UrryUrr/ushayka-sklon-3d/img/fig/r5_design_river.jpg

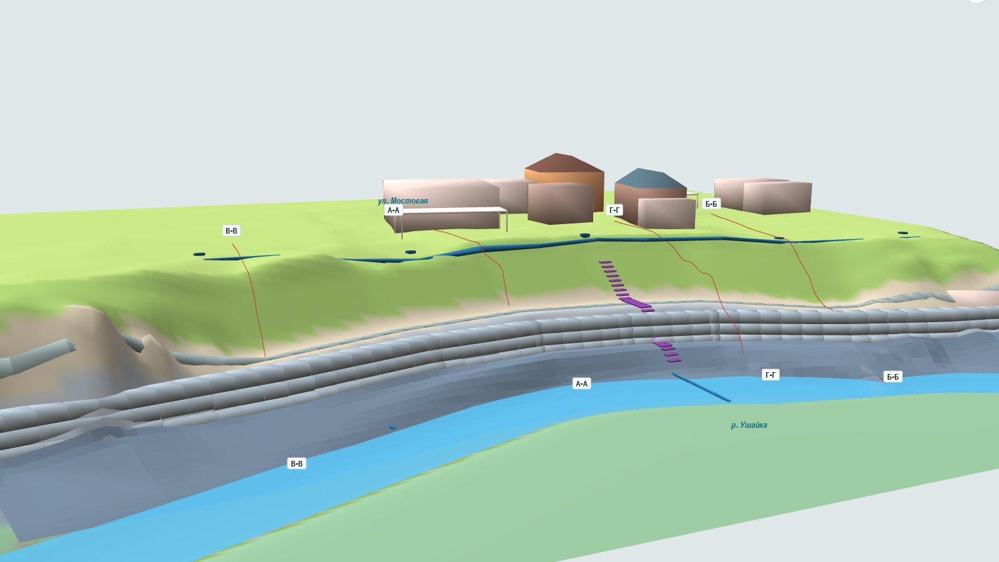
img/fig/r5_design_river.jpg
