UrryUrr/ushayka-sklon-3d/img/fig/r2_design.jpg

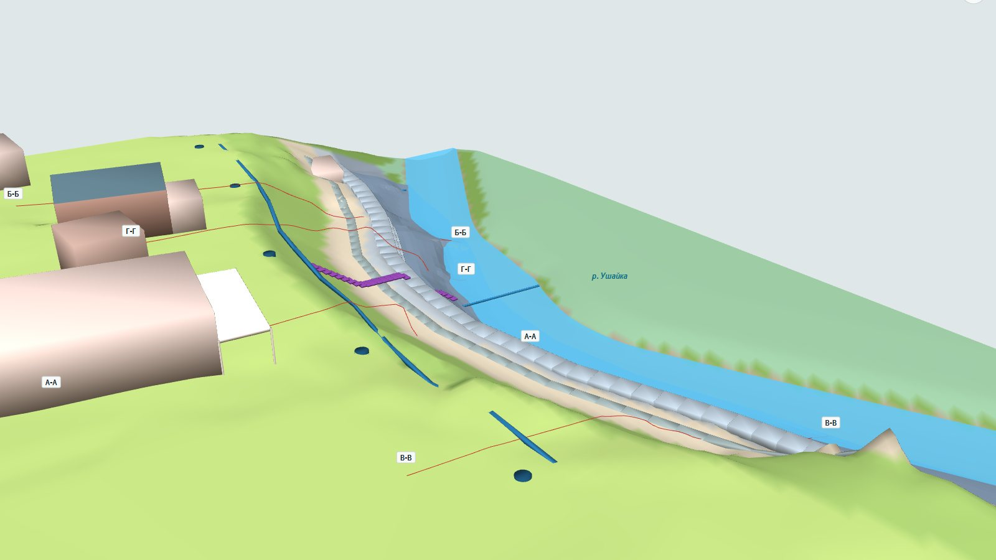
img/fig/r2_design.jpg
