UrryUrr/ushayka-sklon-3d/docs/README.txt

ПРОЕКТ БЕРЕГОУКРЕПЛЕНИЯ — п. Заварзино, ул. Мостовая, 40 (левый берег р. Ушайки)
Шифр 2026-МОС40-ИЗ. Предпроектные решения (концепция) с расчётным обоснованием. ЧЕРНОВИК. Подготовлено 22.10.2026.

СТАТУС
Документы подготовлены по материалам заказчика: отчёту ИГИ 188-07/2024 (ООО «Сибирская Буровая Компания»,
доп. от 02.07.2025) и заключению ООО «НПФ «Инженерные изыскания» (2025). Это не проектная документация организации —
члена СРО. Перед строительством её должен проверить и подписать ГИП такой организации; до рабочей документации
обязательны доизыскания (ПЗ, раздел 15).

СОСТАВ ПАПКИ
01_Пояснительная записка  — ПЗ, 32 стр.: условия, причины деформаций, расчёты, варианты, решения, ПОС, мониторинг,
                            разрешения, стоимость, задание на доизыскания.
02_Чертежи                — 13 листов А2 (PDF): общие данные, планы М 1:400 (существующее, проект), разрезы А-А, Б-Б, В-В,
                            Г-Г М 1:200, контрфорсы ГЦК, габионы и крепление подошвы, дренаж, стройгенплан, мониторинг, 3D.
                            DXF — план проектных решений в МСК-70 (X/Y как в топоплане) и разрезы.
03_Расчёты                — results.json (все коэффициенты устойчивости, оползневое давление, объёмы), графики сечений,
                            исходный код расчётной модели (Python: Бишоп, Спенсер, метод передачи сил, сваи, ЦМР, 3D).
04_3D-модель              — 3D-модель_Заварзино.html (открыть в браузере, нужен интернет для библиотеки three.js),
                            model.obj/.mtl (Civil 3D, Revit, Blender), ЦМР «сущ./проект» (npz), виды PNG.
                            Онлайн-версия: https://urryurr.github.io/ushayka-sklon-3d/ (3D-модель и вся документация).
05_Смета                  — ведомость объёмов по зонам I–III, укрупнённая стоимость (мин/макс, без НДС), варианты по бюджету;
                            «Обоснование стоимости» (PDF): расценки, источники цен, расчёт цены струйной цементации.

ГЛАВНЫЕ ВЫВОДЫ
1. При расчётных характеристиках грунтов (как требует СП 116.13330.2012) устойчивость не обеспечена по всему фронту ≈ 100 м:
   k = 0,93 (А-А), 0,96 (Г-Г), 1,00 (В-В), 1,01 (Б-Б) при норме 1,15; весной (верховодка) 0,87–0,97; при сейсмике 0,84–0,89.
   PLAXIS в заключении дал 1,17 по А-А при нормативных характеристиках; та же модель здесь даёт 1,19–1,21.
   По разрезу Б-Б заключение дало 1,49, наша модель — 1,10: расхождение нужно разобрать с автором заключения.
2. Расчётные поверхности скольжения глубокие (на 13–15 м ниже двора) и выходят в русло; верх — на дворе в 6–8 м от бровки.
3. Рекомендуемое решение: демонтаж аварийных сооружений, перехватывающий дренаж и ГДС, разгрузка откоса 1:1,5, берма +105,
   40 грунтоцементных контрфорсов (струйная цементация, колонны Ø1,0 м, шаг рёбер 2,5 м, низ 90,0), обвязочная балка,
   габионная стена, матрацы Рено с фартуком. Проект: k = 1,25–1,31 (основное), 1,11–1,15 (сейсмика) — норма выполнена.
4. Буронабивные сваи отклонены: в текучих грунтах ниже скольжения велики смещения, не хватает несущей способности
   на выдёргивание, тяжёлая установка на склоне опасна.
5. Стоимость ориентировочная (±30 %, без НДС; обоснование — 05_Смета, «Обоснование стоимости»): всего 88–139 млн руб.;
   этап 0 + 1 (аварийная зона I, ≈ 42 м) — 43–70 млн руб.; неотложный этап (дренаж, доизыскания, датчики) — 7,9–13,6 млн руб.;
   первоочередные меры — 1,6–2,9 млн руб.
   После CD-испытаний грунтов стоимость рёбер в зонах II–III может снизиться на 30–50 % или вырасти, если грунты окажутся хуже.
   С НДС 22 %: ≈ 107–170 млн руб. (весь участок), ≈ 53–85 млн руб. (первая очередь).
6. Сейсмика 7 баллов: по Спенсеру 1,09–1,13 при норме 1,09 — на пределе, без запаса; в РД добавить запас на участках В-В и Г-Г.
7. Во время стройки, пока рёбра не готовы, запас ниже нормы (1,01–1,05 при 1,09) — короткие захватки и ежедневный контроль.

СДЕЛАТЬ СРАЗУ (этап 0)
— закрыть доступ на склон в зоне I (у сечения А-А) и запретить его использование арендаторам;
— убрать нагрузки в полосе 10 м от бровки, отвести воду с кровель и плато от склона;
— просверлить разгрузочные отверстия в стенах W2, W3, W5, W6;
— заказать доизыскания (глубокие скважины 25–30 м, CD/CU-испытания, гидрология, промеры), инклинометры И-1…И-3;
— начать оформление прав на землю под склоном и водопользования (склон — вне участков, в водоохранной зоне).

ЗАМЕЧАНИЯ К ИСХОДНЫМ МАТЕРИАЛАМ
— Координаты скв. С-3 и С-4 в каталоге ИГИ расходятся с картой и разрезами на 5 и 18 м (принято по карте).
— В прил. Ж ИГИ «расчётные» φ и c для ИГЭ-304 (21–24°, 23–34 кПа) и ИГЭ-406 противоречат испытаниям (прил. Е).
— Гидрография в ИГИ описана по р. Малой Ушайке; гидрологических изысканий нет — РУВВ 103,00 принят условно.
— Скважины на склоне пройдены лишь до 3–4 м; ниже отм. 94,5 данных нет.

ПАРАЛЛЕЛЬНЫЙ ПРОЕКТ
Первоочередные меры с минимальным бюджетом и оценка предложения по винтовым сваям (шифр 2026-МОС40-ПМ) —
отдельная папка «Проект первоочередных мер 2026» рядом с этой; страница: https://urryurr.github.io/ushayka-sklon-3d/pm/
