UrryUrr/ushayka-sklon-3d/img/fig/f1_now.jpg

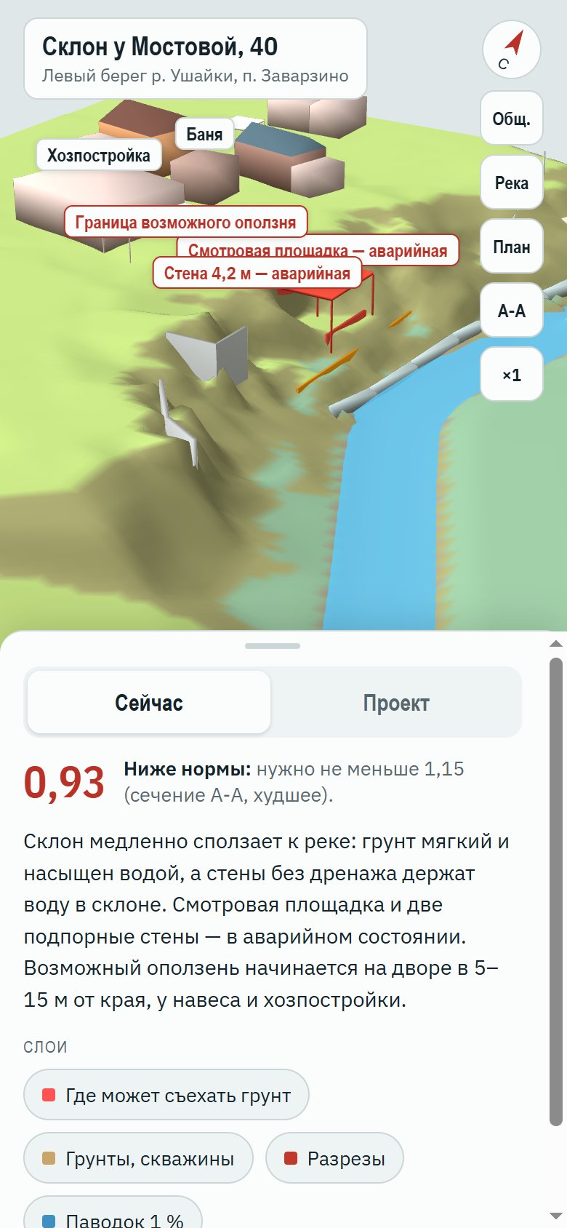
img/fig/f1_now.jpg
