UrryUrr/ushayka-sklon-3d/img/fig/f2_prj.jpg

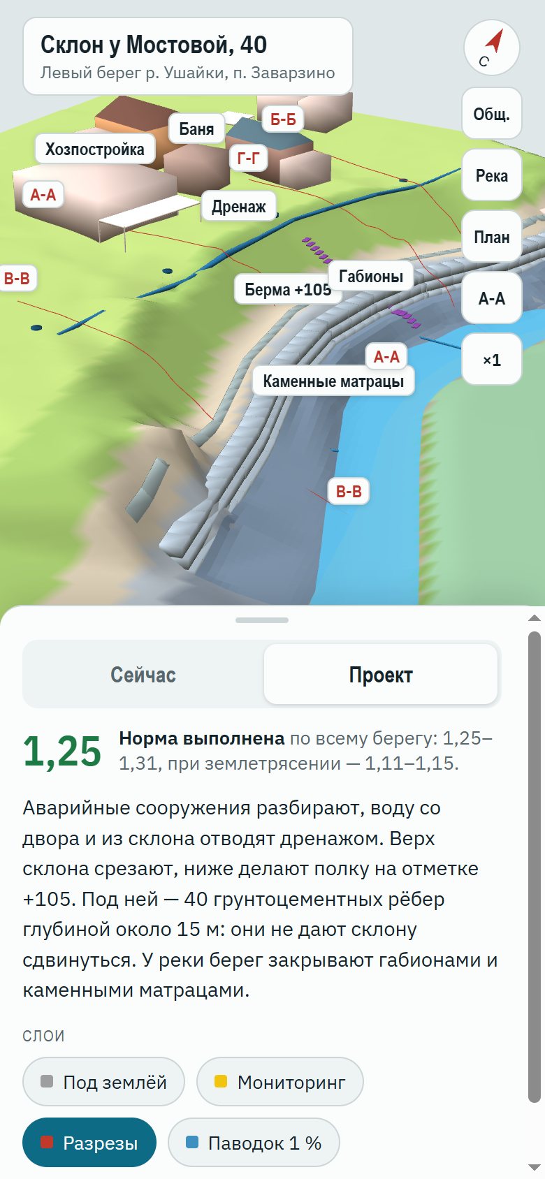
img/fig/f2_prj.jpg
