UrryUrr/ushayka-sklon-3d/img/fig/f3_ug.jpg

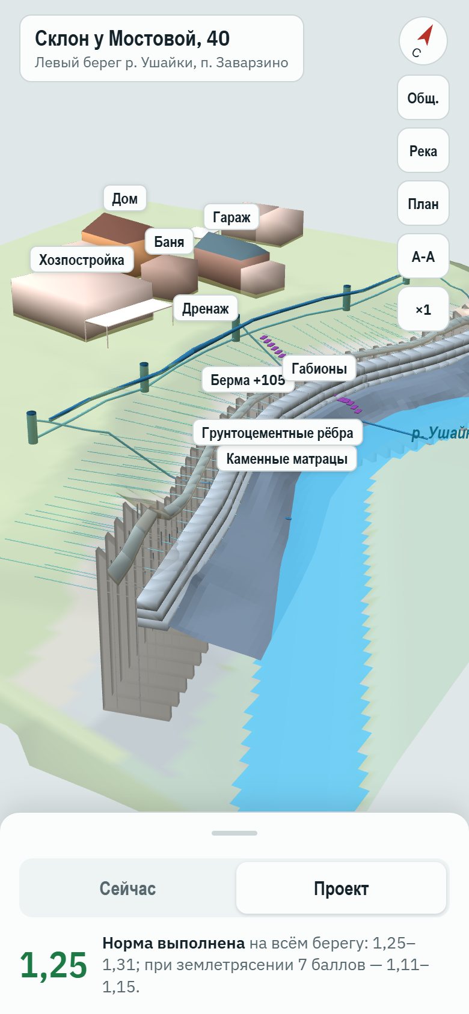
img/fig/f3_ug.jpg
