UrryUrr/ushayka-sklon-3d/img/fig/photo2.jpg

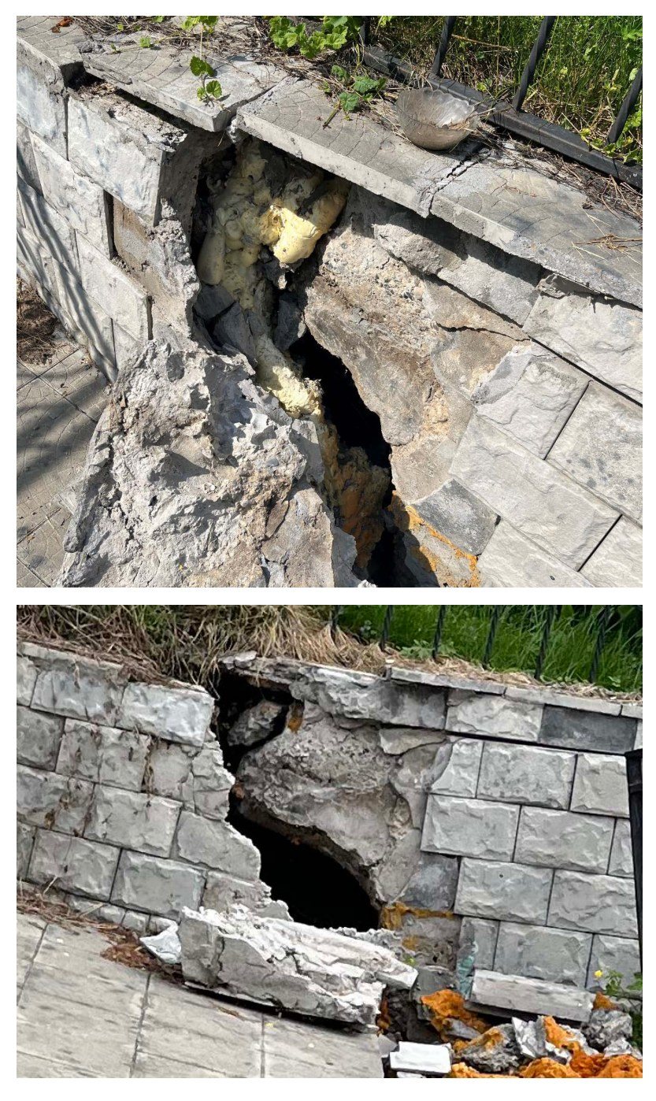
img/fig/photo2.jpg
