UrryUrr/ushayka-sklon-3d/img/fig/photo.jpg

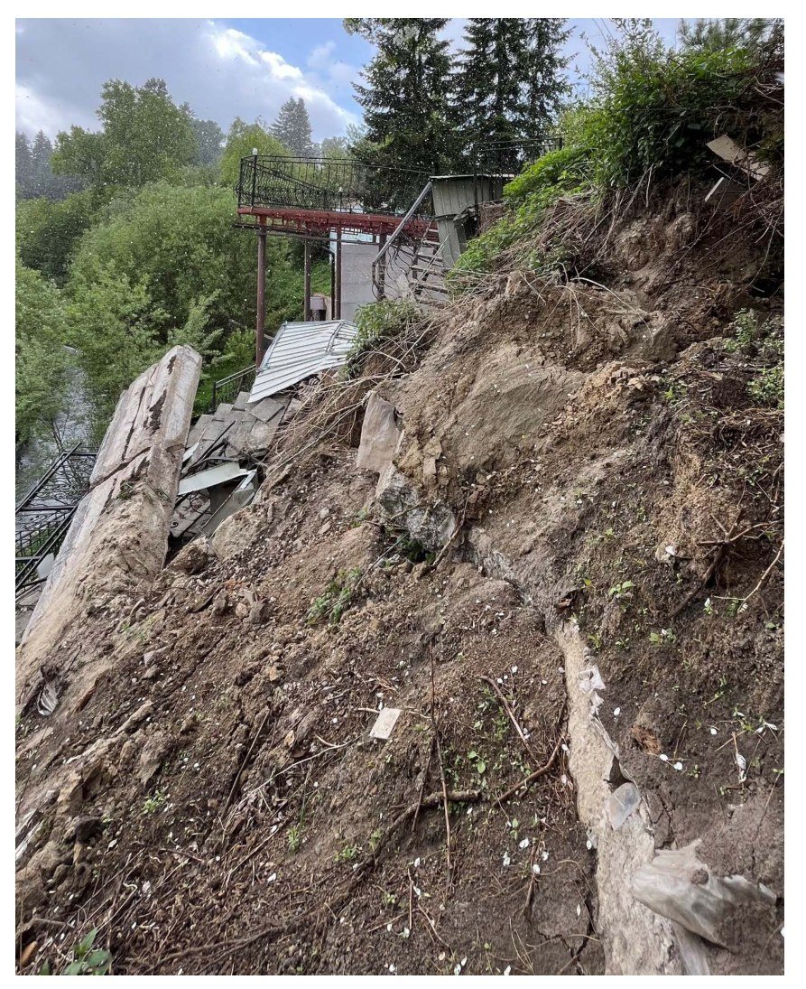
img/fig/photo.jpg
