UrryUrr/ushayka-sklon-3d/img/fig/r1_exist.jpg

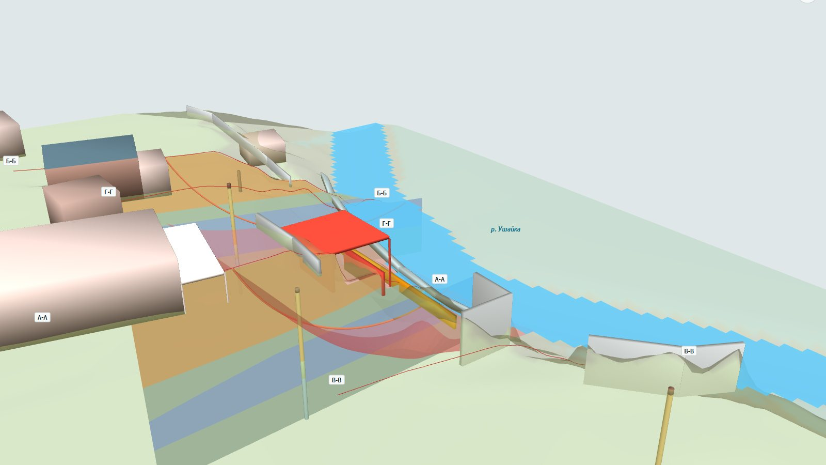
img/fig/r1_exist.jpg
