UrryUrr/ushayka-sklon-3d/img/fig/r4_exist_river.jpg

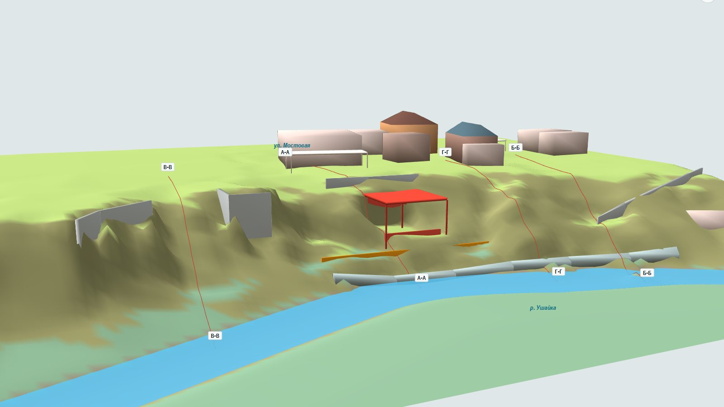
img/fig/r4_exist_river.jpg
