UrryUrr/ushayka-sklon-3d/img/fig/r7_plan.jpg

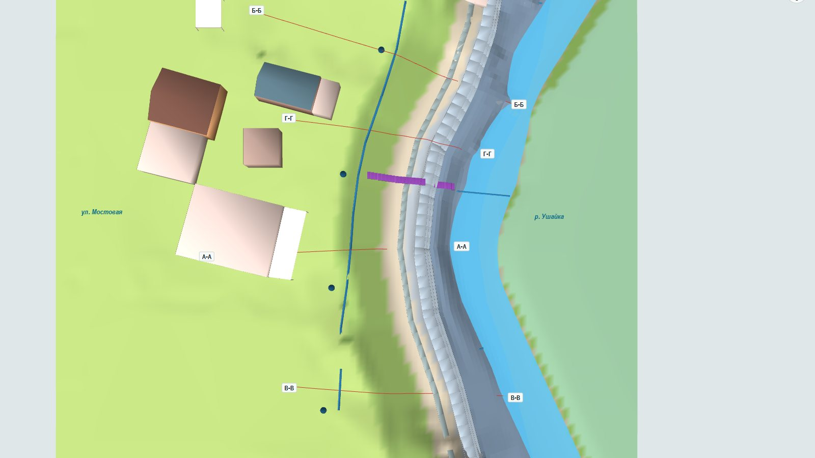
img/fig/r7_plan.jpg
