UrryUrr/ushayka-sklon-3d/img/fig/r8_aa.jpg

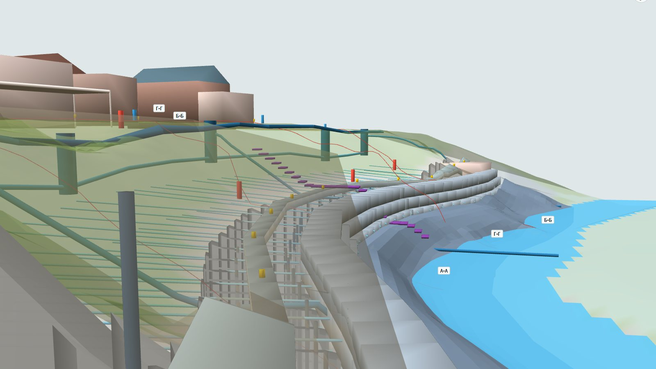
img/fig/r8_aa.jpg
