UrryUrr/ushayka-sklon-3d/img/fig/sec_GG.jpg

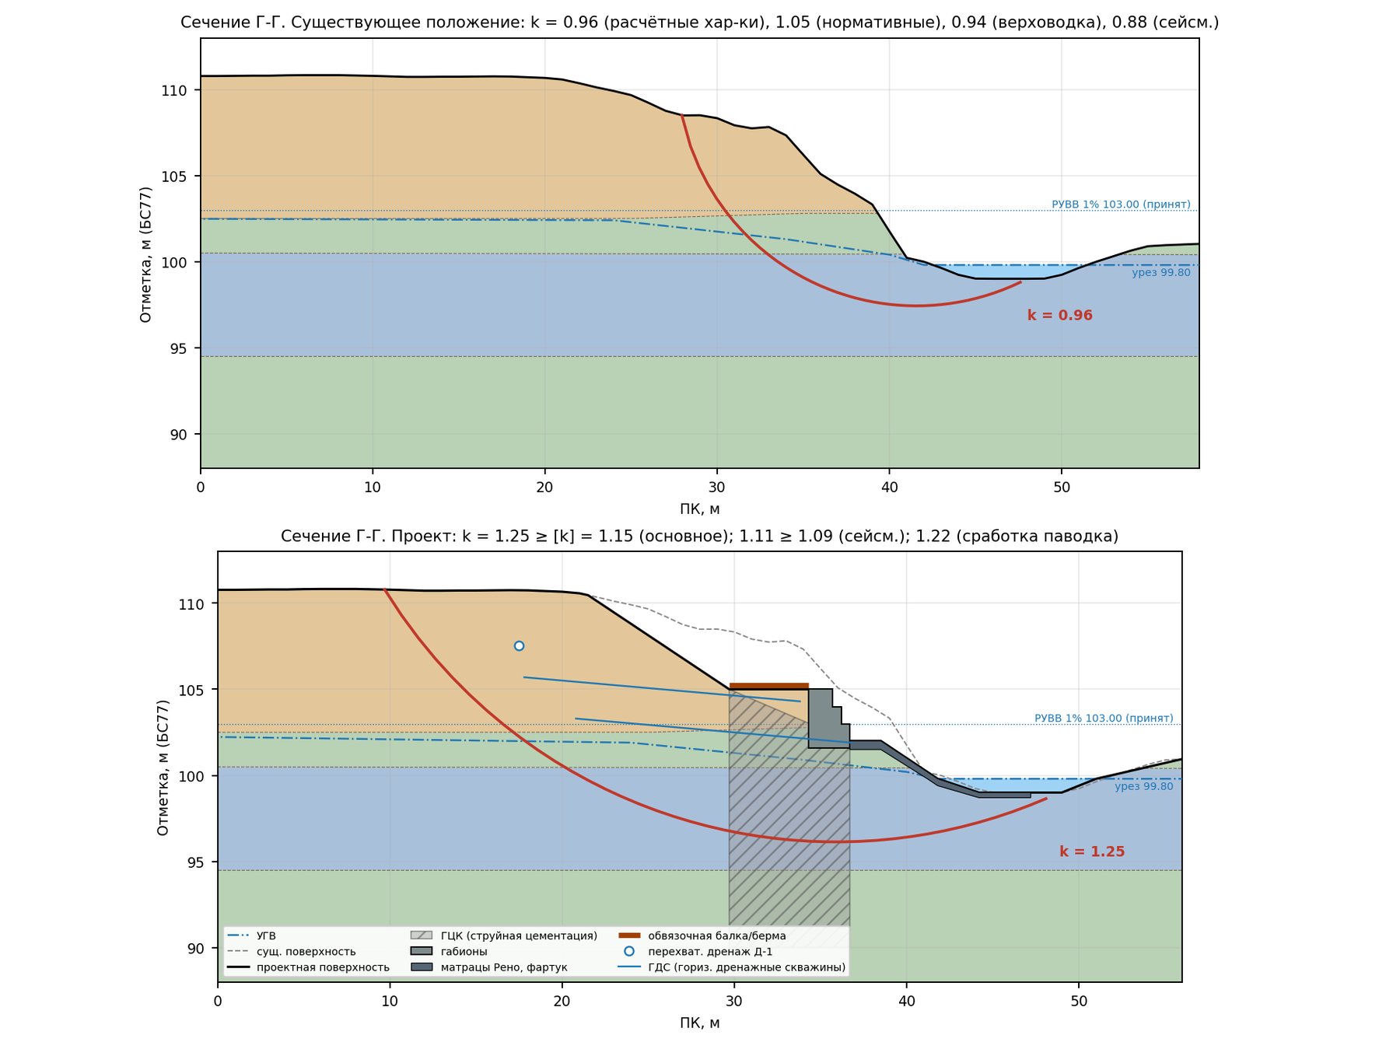
img/fig/sec_GG.jpg
