UrryUrr/ushayka-sklon-3d/img/fig/sec_VV.jpg

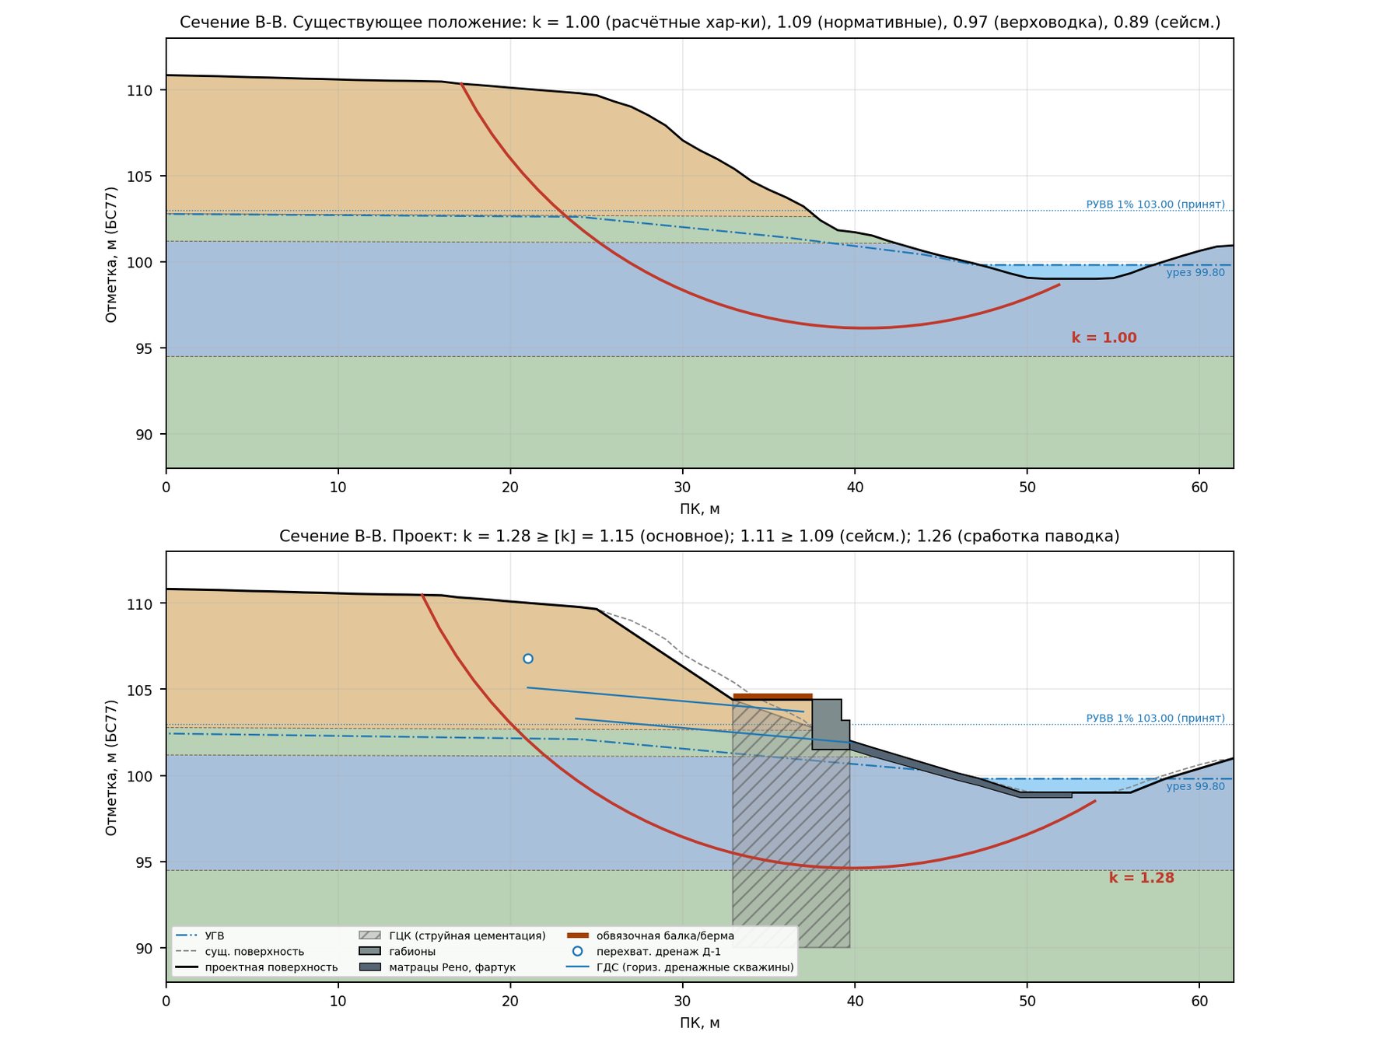
img/fig/sec_VV.jpg
