UrryUrr/ushayka-sklon-3d/img/fig/thrust.jpg

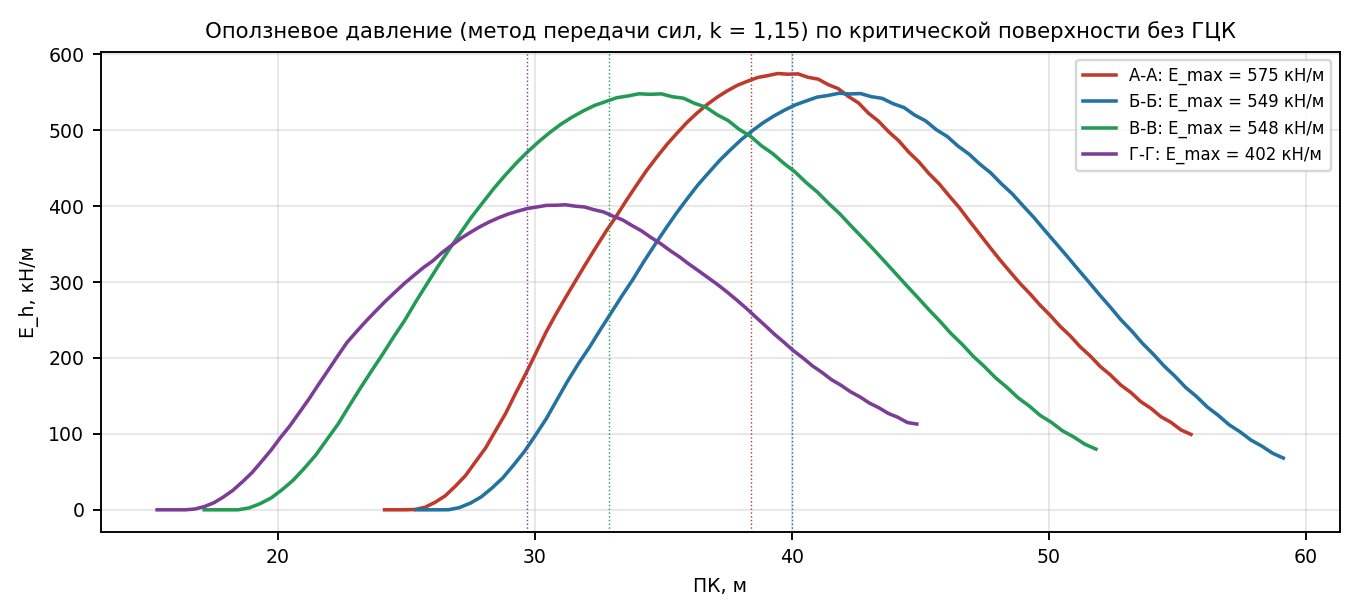
img/fig/thrust.jpg
