UrryUrr/ushayka-sklon-3d/img/sheets/list_01.jpg

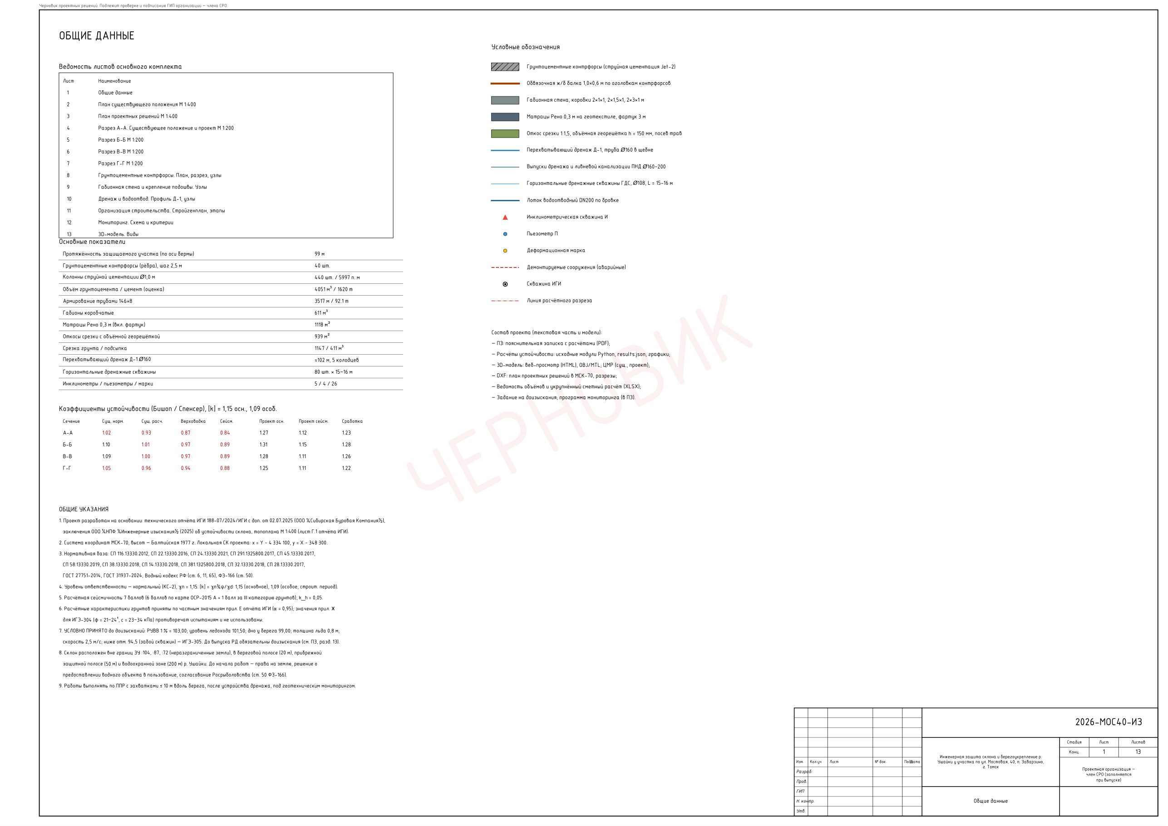
img/sheets/list_01.jpg
