UrryUrr/ushayka-sklon-3d/img/sheets/list_02.jpg

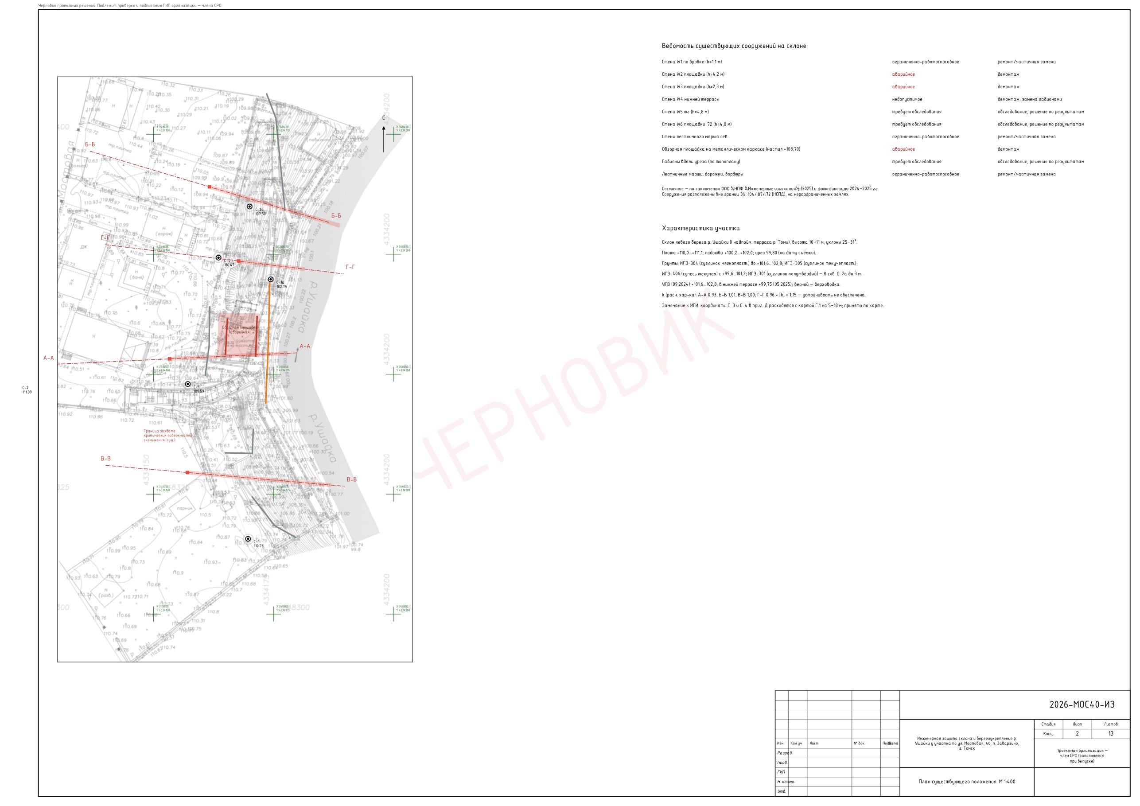
img/sheets/list_02.jpg
