UrryUrr/ushayka-sklon-3d/img/sheets/list_03.jpg

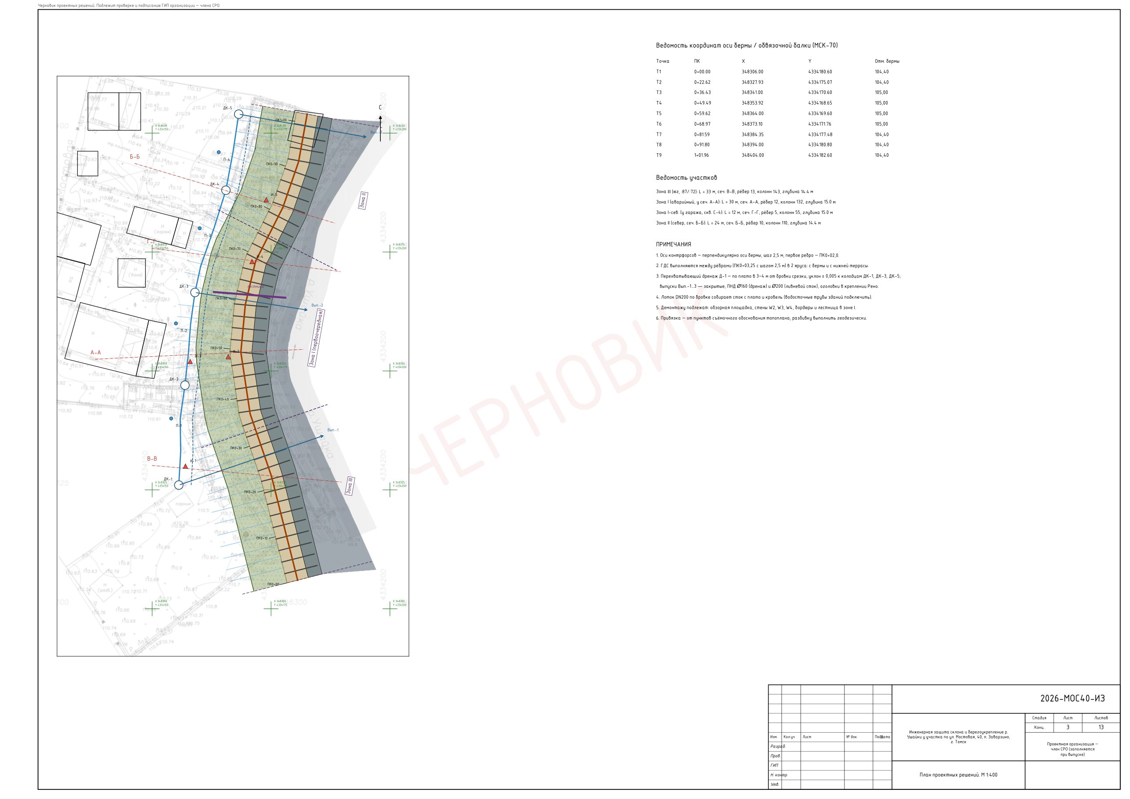
img/sheets/list_03.jpg
