UrryUrr/ushayka-sklon-3d/img/sheets/list_04.jpg

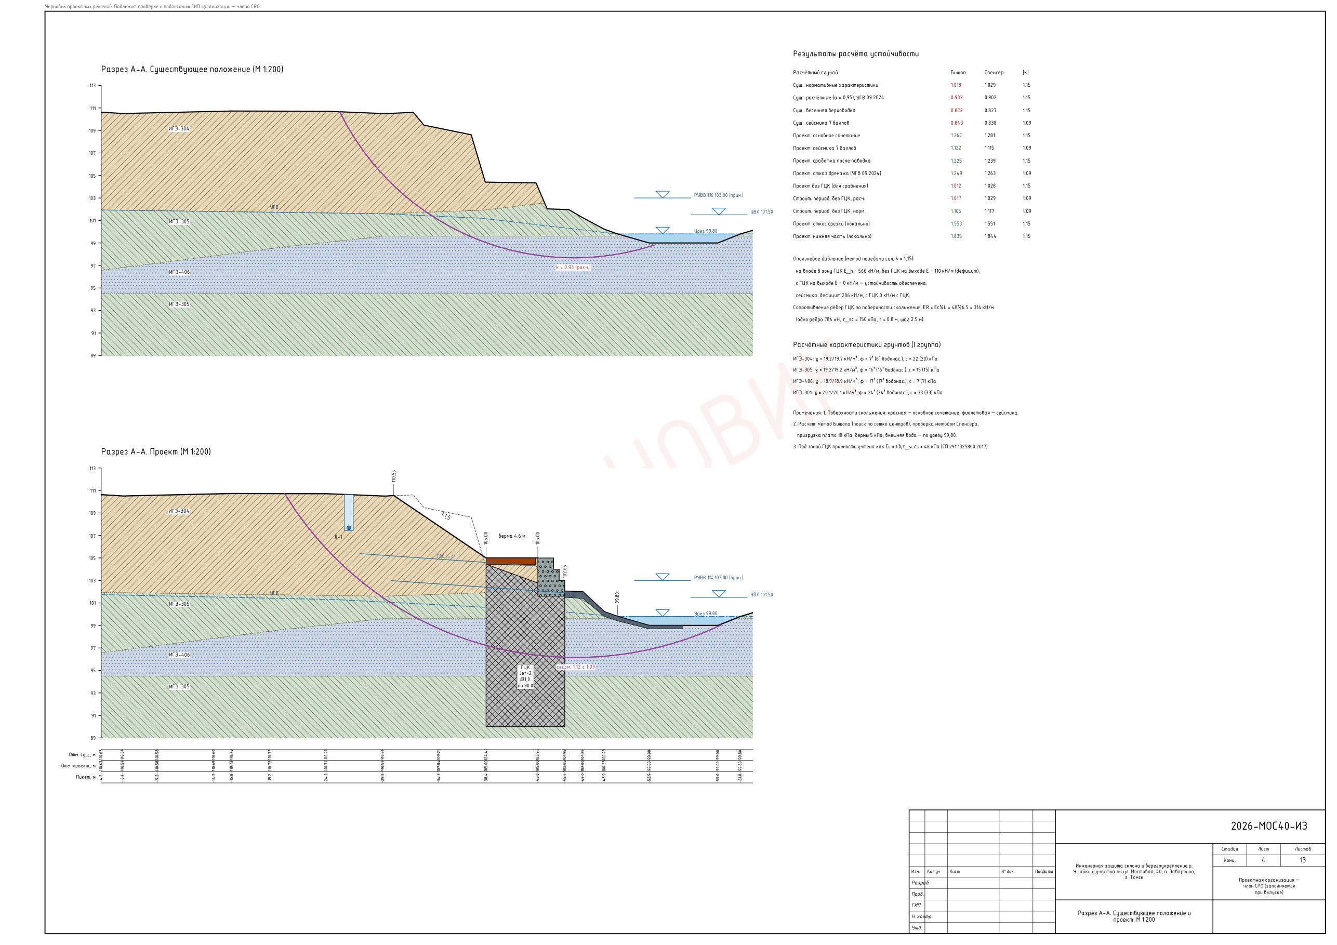
img/sheets/list_04.jpg
