UrryUrr/ushayka-sklon-3d/img/sheets/list_08.jpg

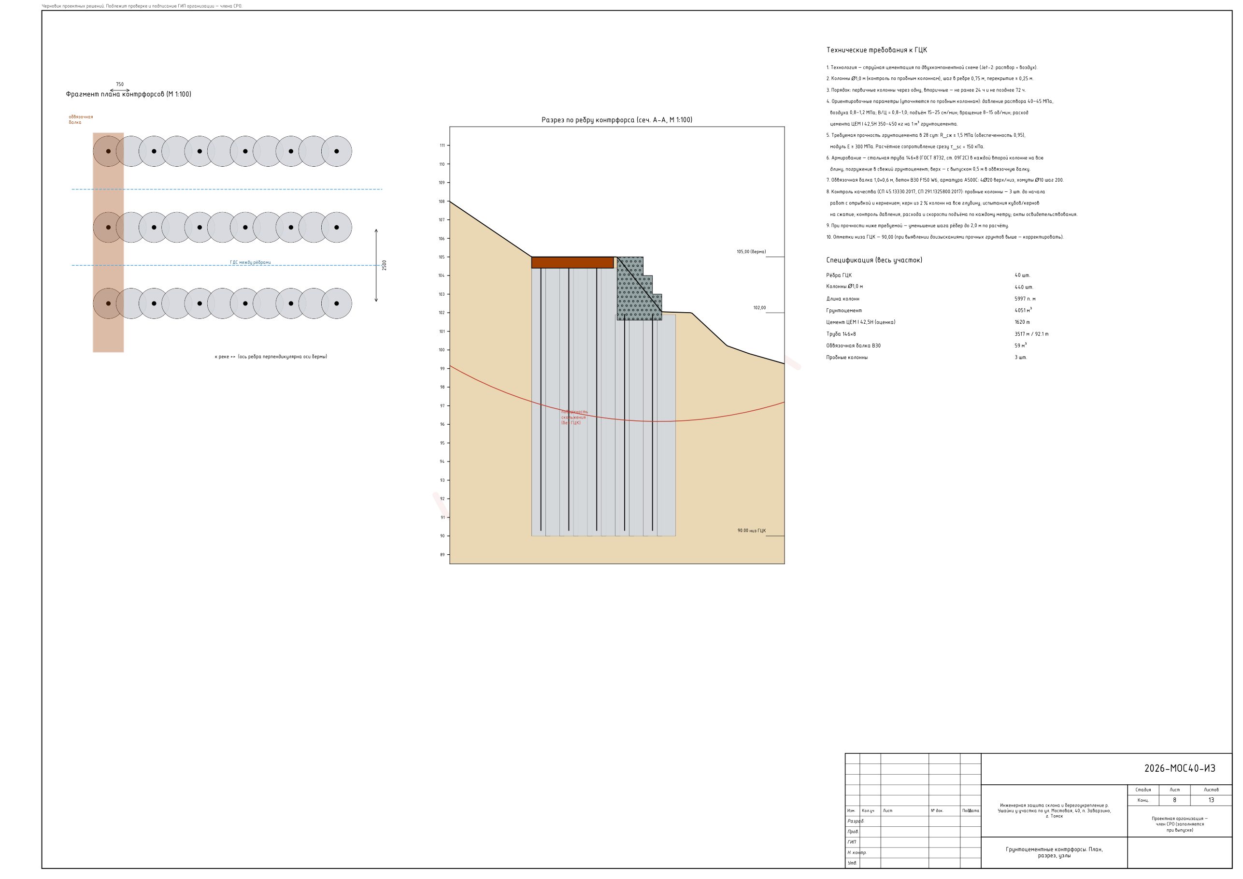
img/sheets/list_08.jpg
