UrryUrr/ushayka-sklon-3d/img/sheets/list_09.jpg

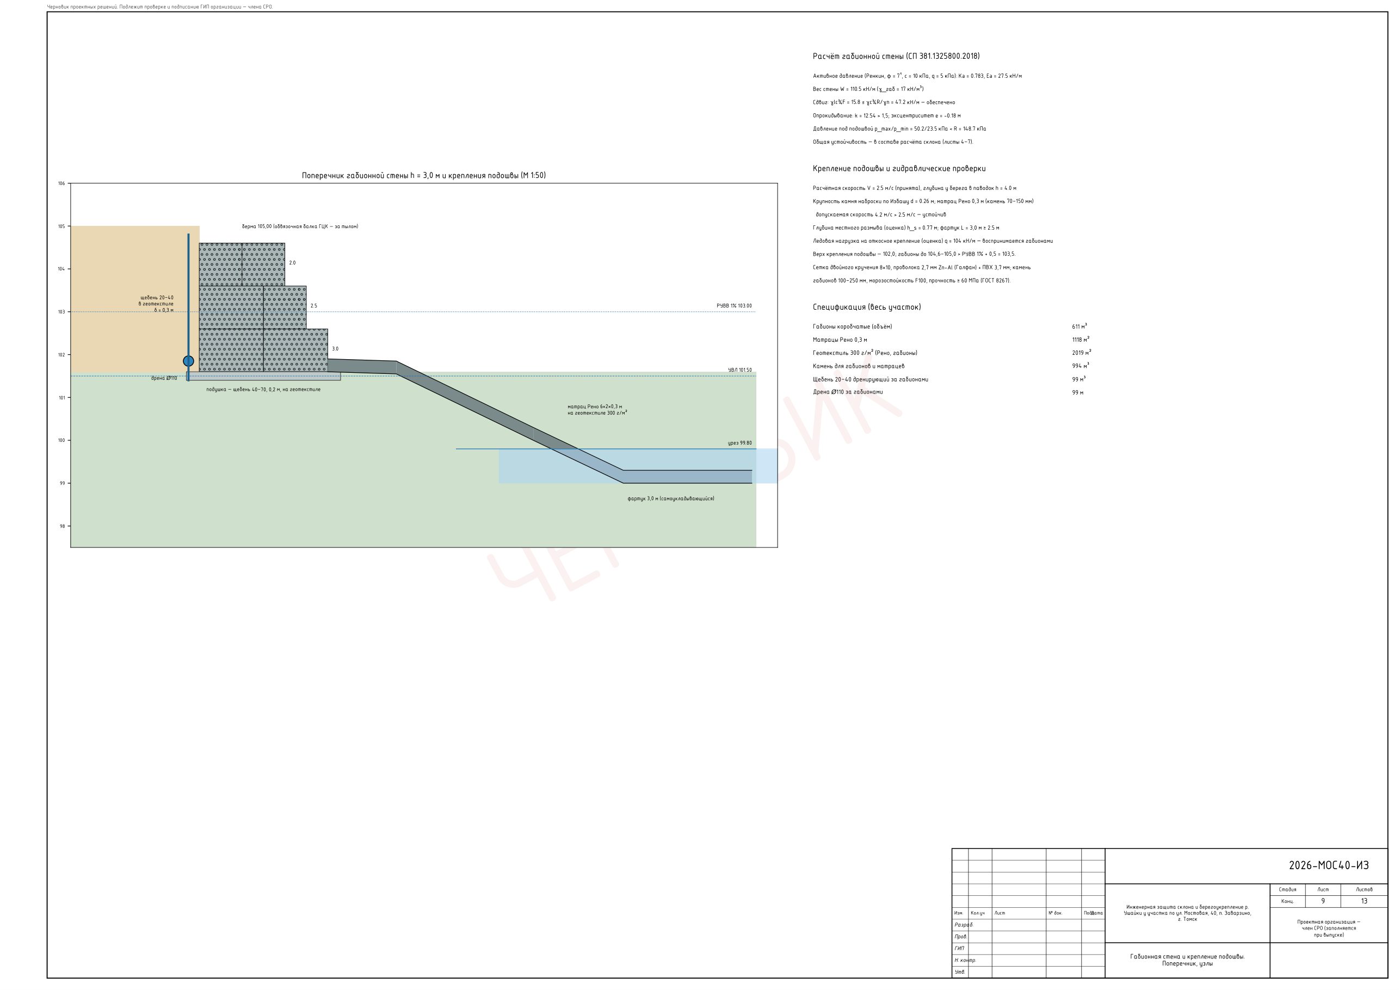
img/sheets/list_09.jpg
