UrryUrr/ushayka-sklon-3d/img/sheets/list_10.jpg

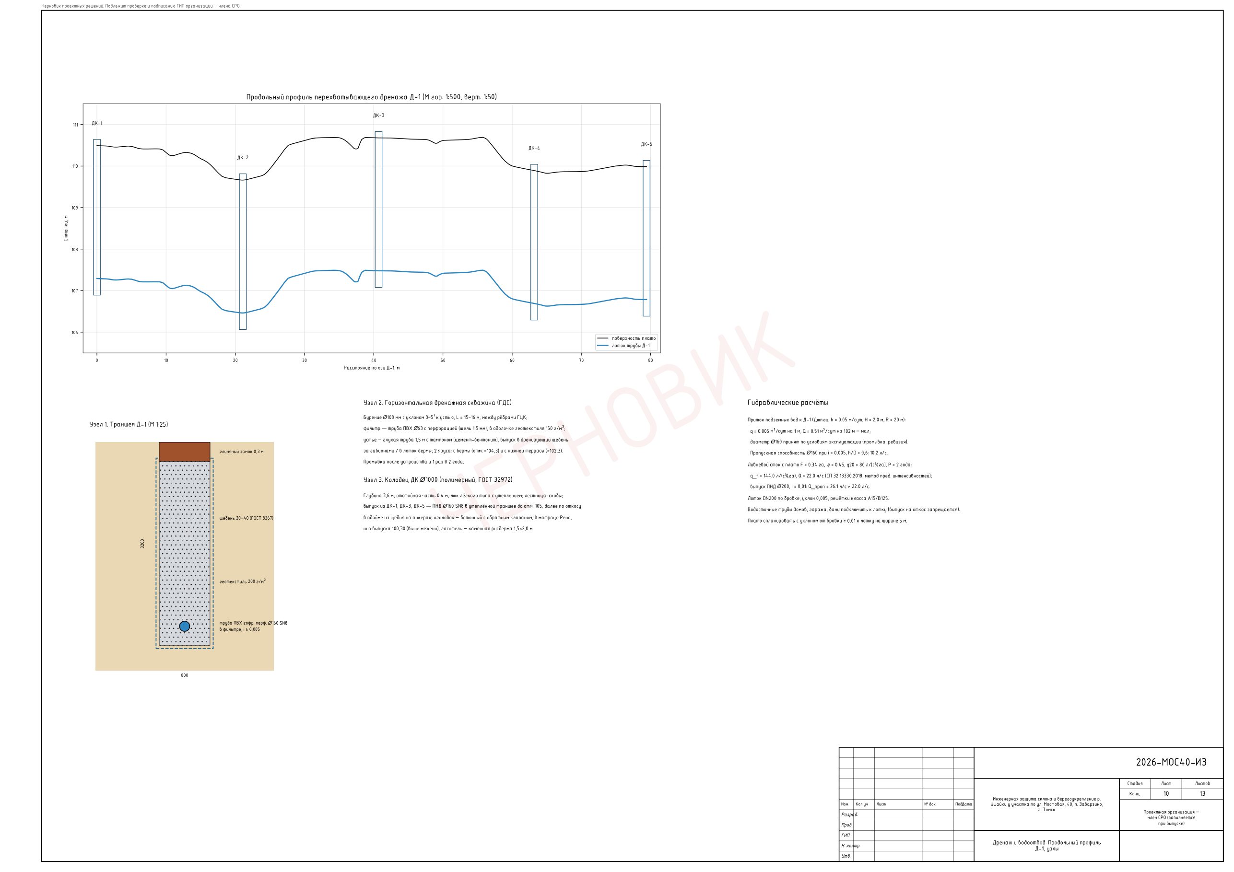
img/sheets/list_10.jpg
