UrryUrr/ushayka-sklon-3d/img/sheets/list_12.jpg

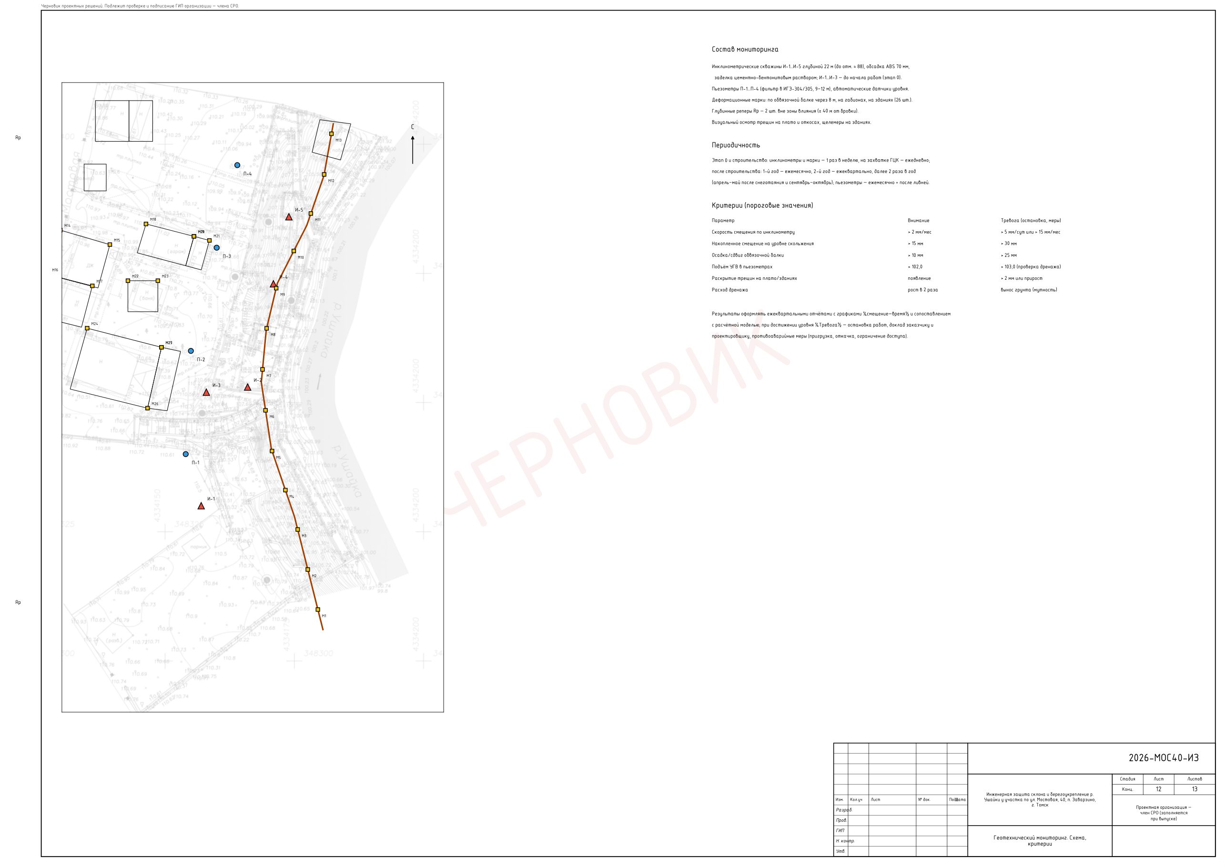
img/sheets/list_12.jpg
