UrryUrr/ushayka-sklon-3d/img/sheets/list_13.jpg

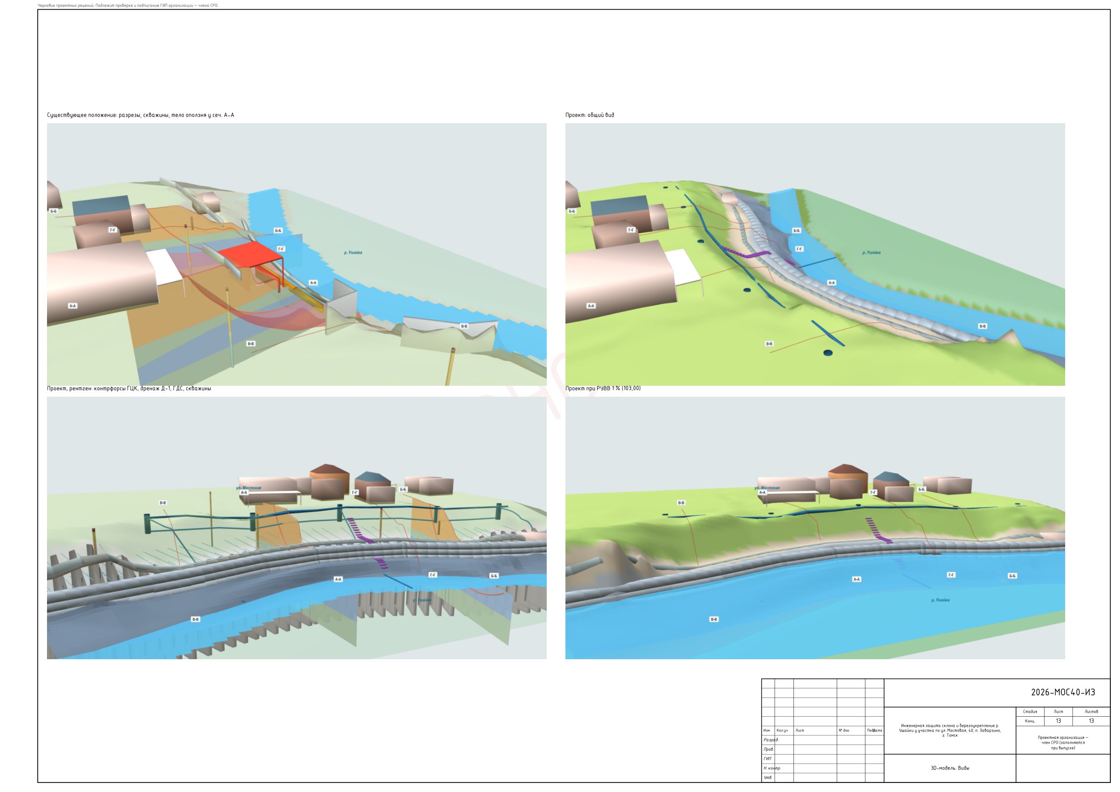
img/sheets/list_13.jpg
