UrryUrr/ushayka-sklon-3d/pm/img/plan.jpg

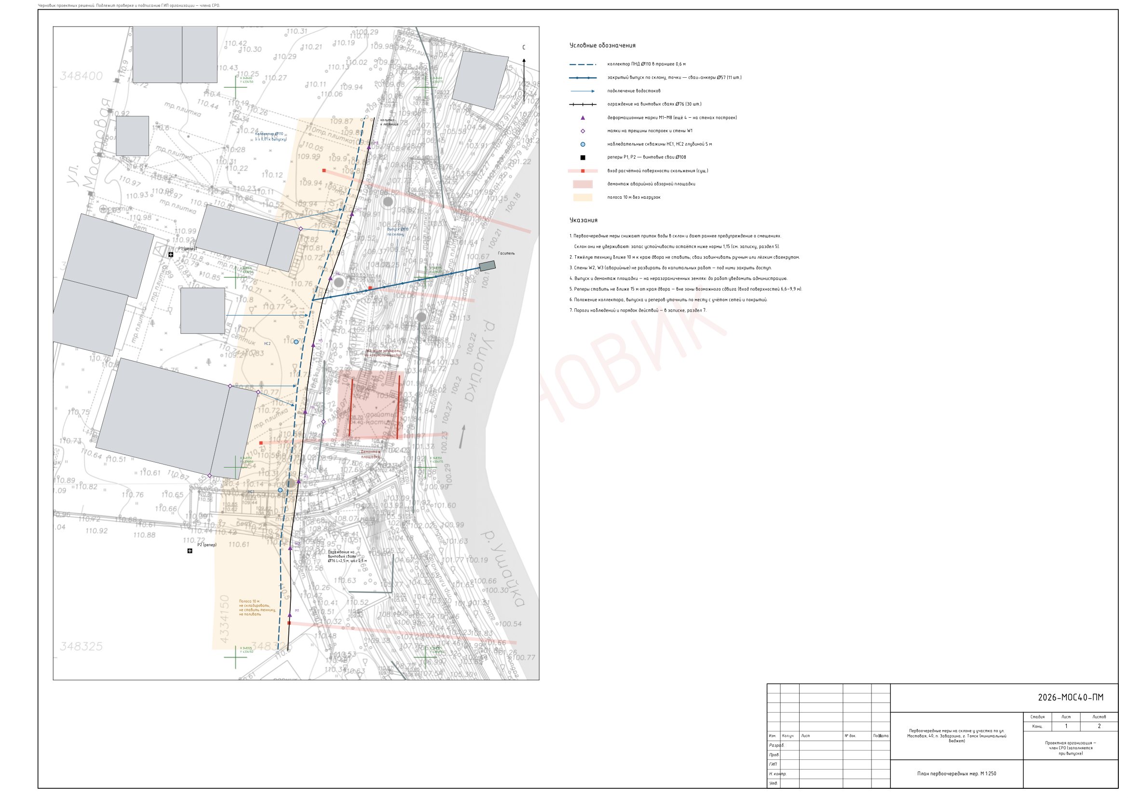
pm/img/plan.jpg
