UrryUrr/ushayka-sklon-3d/pm/img/section.jpg

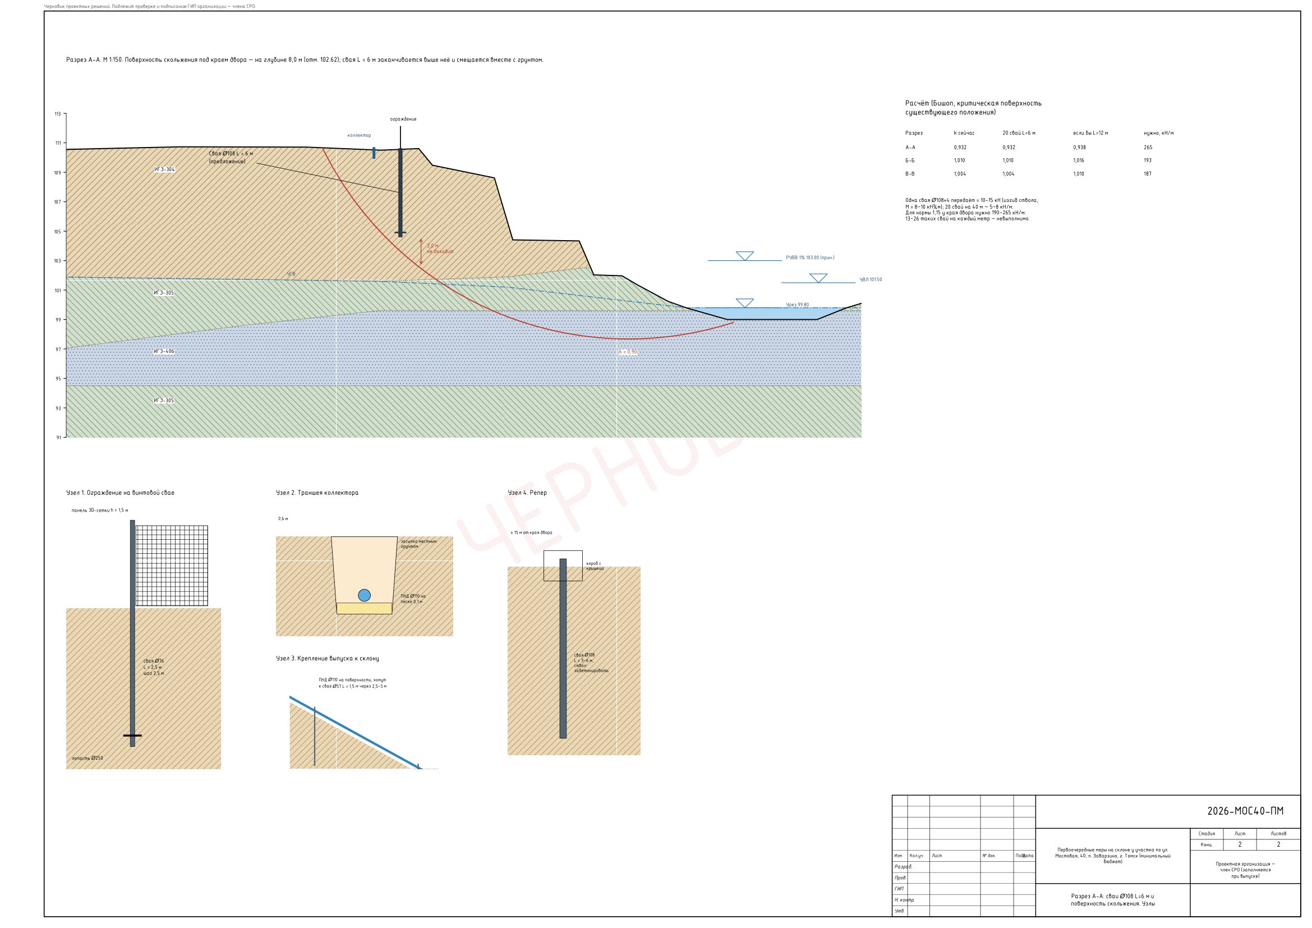
pm/img/section.jpg
