UrryUrr/ushayka-sklon-3d/docs/Smeta_2026-MOS40.xlsx

Sheet: Ведомость объёмов
Ведомость объёмов работ. Шифр 2026-МОС40-ИЗ. Объёмы по расчётной модели; уточняются в РД.
№ | Раздел | Наименование работ | Ед. | Зона I (42 м) | Зона II (24 м) | Зона III (33 м) | Всего
1 | 0. Подготовка | Доизыскания: ИГИ (4 скв. 25–30 м, CD/CU, CPTU), гидрометеорология, геодезия, обследование | компл. | 1.00 | 0.00 | 0.00
2 | 0. Подготовка | Рабочая документация (организация — член СРО), авторский надзор | компл. | 1.00 | 0.00 | 0.00
3 | 0. Подготовка | Разрешительная документация (земля, водопользование, Росрыболовство) | компл. | 1.00 | 0.00 | 0.00
4 | 0. Подготовка | Мобилизация оборудования струйной цементации, временный съезд и рабочая площадка на склоне | компл. | 1.00 | 0.25 | 0.25
5 | 0. Подготовка | Противоаварийные меры: ограждение, знаки, временный водоотвод | компл. | 1.00 | 0.00 | 0.00
6 | 1. Демонтаж | Демонтаж обзорной площадки (металлокаркас ≈ 8 т, настил) | компл. | 1.00 | 0.00 | 0.00
7 | 1. Демонтаж | Разборка ж/б стен W1–W4, бордюров с вывозом | м³ | 33.00 | 6.00 | 10.00
8 | 2. Земляные работы | Срезка грунта на склоне с вывозом за пределы водоохранной зоны | м³ | 774.60 | 160.80 | 211.20
9 | 2. Земляные работы | Подсыпка бермы с уплотнением Kcom ≥ 0,95 | м³ | 213.00 | 26.40 | 171.60
10 | 3. Грунтоцементные рёбра | Колонны струйной цементации Jet-2 Ø1,0 м (с цементом, вывоз шлама) | п. м | 2608.00 | 1473.00 | 1915.00
11 | 3. Грунтоцементные рёбра | Пробные колонны (3 шт.), откопка, кернение, испытания | компл. | 1.00 | 0.00 | 0.00
12 | 3. Грунтоцементные рёбра | Армирование трубой 146×8 (поставка и погружение) | т | 40.09 | 22.64 | 29.42
13 | 3. Грунтоцементные рёбра | Контроль качества: керн 2 % колонн, лаборатория | компл. | 0.42 | 0.25 | 0.33
14 | 4. Балка | Обвязочная ж/б балка 1,0×0,6 м B30 (арматура, опалубка) | м³ | 25.20 | 14.40 | 19.80
15 | 5. Габионы и крепление | Габионы коробчатые с камнем, сетка Zn-Al+ПВХ | м³ | 279.72 | 140.16 | 190.74
16 | 5. Габионы и крепление | Матрацы Рено 0,3 м на геотекстиле (вкл. подводную часть, фартук) | м² | 423.60 | 288.00 | 405.90
17 | 5. Габионы и крепление | Щебёночная подушка, дренирующая засыпка за габионами с дреной Ø110 | п. м | 42.00 | 24.00 | 33.00
18 | 6. Дренаж | Перехватывающий дренаж Д-1 (траншея 3,2 м, щебень, труба Ø160) | п. м | 42.00 | 34.00 | 26.00
19 | 6. Дренаж | Колодцы ДК Ø1000 полимерные | шт. | 2.00 | 2.00 | 1.00
20 | 6. Дренаж | Выпуски ПНД Ø160–200 с оголовками | шт. | 1.00 | 1.00 | 1.00
21 | 6. Дренаж | Горизонтальные дренажные скважины Ø108, L = 15,5 м | п. м | 527.00 | 310.00 | 403.00
22 | 7. Водоотвод | Лоток DN200 с решётками по бровке, подключение водостоков | п. м | 42.00 | 34.00 | 26.00
23 | 8. Откосы | Объёмная георешётка h = 150 мм, анкеры, растительный грунт, посев | м² | 410.40 | 218.40 | 310.20
24 | 8. Откосы | Посадка кустарника (ива, кизильник, спирея) | шт. | 63.00 | 36.00 | 49.50
25 | 9. Благоустройство | Лестница металлическая на винтовых сваях с площадками | компл. | 1.00 | 0.00 | 0.00
26 | 10. Мониторинг | Инклинометрические скважины 22 м | шт. | 3.00 | 1.00 | 1.00
27 | 10. Мониторинг | Пьезометры | шт. | 2.00 | 1.00 | 1.00
28 | 10. Мониторинг | Наблюдения и отчёты (строительство + 2 года) | компл. | 0.60 | 0.20 | 0.20

Sheet: Смета укрупнённая
Укрупнённый расчёт стоимости (ориентировочно), руб., цены IV кв. 2026 г., без НДС. Точность ±30 %.
Расценки — по открытым рыночным данным 2025–2026 гг. и расчёту по материалоёмкости (см. «Обоснование стоимости»); перед договорами — КП подрядчиков.
№ | Раздел | Наименование | Ед. | Кол-во всего | Цена мин | Цена макс | Сумма мин | Сумма макс | Зона I мин | Зона I макс | Примечание
1 | 0. Подготовка | Доизыскания: ИГИ (4 скв. 25–30 м, CD/CU, CPTU), гидрометеорология, геодезия, обследование | компл. |  | 1500000 | 2500000 |  |  |  |  | раздел 15 ПЗ
2 | 0. Подготовка | Рабочая документация (организация — член СРО), авторский надзор | компл. |  | 2500000 | 4000000 |  |  |  |  | ≈ 3–5 % стоимости работ
3 | 0. Подготовка | Разрешительная документация (земля, водопользование, Росрыболовство) | компл. |  | 300000 | 900000 |  |  |  |  | раздел 13 ПЗ
4 | 0. Подготовка | Мобилизация оборудования струйной цементации, временный съезд и рабочая площадка на склоне | компл. |  | 1500000 | 3000000 |  |  |  |  | зоны II–III — 25 %
5 | 0. Подготовка | Противоаварийные меры: ограждение, знаки, временный водоотвод | компл. |  | 250000 | 500000
6 | 1. Демонтаж | Демонтаж обзорной площадки (металлокаркас ≈ 8 т, настил) | компл. |  | 300000 | 600000
7 | 1. Демонтаж | Разборка ж/б стен W1–W4, бордюров с вывозом | м³ |  | 7000 | 12000
8 | 2. Земляные работы | Срезка грунта на склоне с вывозом за пределы водоохранной зоны | м³ |  | 900 | 1500
9 | 2. Земляные работы | Подсыпка бермы с уплотнением Kcom ≥ 0,95 | м³ |  | 600 | 1000
10 | 3. Грунтоцементные рёбра | Колонны струйной цементации Jet-2 Ø1,0 м (с цементом, вывоз шлама) | п. м |  | 6500 | 10500 |  |  |  |  | главная статья
11 | 3. Грунтоцементные рёбра | Пробные колонны (3 шт.), откопка, кернение, испытания | компл. |  | 600000 | 1000000
12 | 3. Грунтоцементные рёбра | Армирование трубой 146×8 (поставка и погружение) | т |  | 120000 | 160000 |  |  |  |  | оценка, уточнить КП
13 | 3. Грунтоцементные рёбра | Контроль качества: керн 2 % колонн, лаборатория | компл. |  | 600000 | 900000
14 | 4. Балка | Обвязочная ж/б балка 1,0×0,6 м B30 (арматура, опалубка) | м³ |  | 30000 | 45000
15 | 5. Габионы и крепление | Габионы коробчатые с камнем, сетка Zn-Al+ПВХ | м³ |  | 8000 | 12000
16 | 5. Габионы и крепление | Матрацы Рено 0,3 м на геотекстиле (вкл. подводную часть, фартук) | м² |  | 2800 | 4500
17 | 5. Габионы и крепление | Щебёночная подушка, дренирующая засыпка за габионами с дреной Ø110 | п. м |  | 4000 | 6500
18 | 6. Дренаж | Перехватывающий дренаж Д-1 (траншея 3,2 м, щебень, труба Ø160) | п. м |  | 9000 | 15000
19 | 6. Дренаж | Колодцы ДК Ø1000 полимерные | шт. |  | 90000 | 150000
20 | 6. Дренаж | Выпуски ПНД Ø160–200 с оголовками | шт. |  | 150000 | 250000
21 | 6. Дренаж | Горизонтальные дренажные скважины Ø108, L = 15,5 м | п. м |  | 2500 | 4000
22 | 7. Водоотвод | Лоток DN200 с решётками по бровке, подключение водостоков | п. м |  | 4500 | 7000
23 | 8. Откосы | Объёмная георешётка h = 150 мм, анкеры, растительный грунт, посев | м² |  | 800 | 1300
24 | 8. Откосы | Посадка кустарника (ива, кизильник, спирея) | шт. |  | 600 | 1200
25 | 9. Благоустройство | Лестница металлическая на винтовых сваях с площадками | компл. |  | 1200000 | 2000000 |  |  |  |  | на устойчивость не влияет
26 | 10. Мониторинг | Инклинометрические скважины 22 м | шт. |  | 150000 | 250000
27 | 10. Мониторинг | Пьезометры | шт. |  | 80000 | 120000
28 | 10. Мониторинг | Наблюдения и отчёты (строительство + 2 года) | компл. |  | 1000000 | 1800000
 |  | Итого
 |  | Непредвиденные работы и затраты, 10 %
 |  | ВСЕГО без НДС
 |  | НДС — по ставке, действующей на дату договора

Sheet: Очерёдность
Рекомендуемая очерёдность финансирования (млн руб. без НДС, с непредвиденными 10 %, ориентировочно)
Этап | Состав | Мин | Макс
Этап 0 + 1 (зона I, ≈ 42 м) | Противоаварийные меры, доизыскания, РД, разрешения; демонтаж, дренаж, ГЦК зоны I, балка, габионы, Рено, откосы, лестница, мониторинг | 43.3 | 69.7
Этап 2 (зоны II–III, ≈ 57 м) | После доизысканий и 1 года мониторинга; возможна оптимизация ГЦК на 30–50 % | 44.3 | 69.6
Всего |  | 87.6 | 139.3

Sheet: Варианты
Варианты по бюджету (ориентировочно, млн руб. без НДС, с непредвиденными)
Вариант | Состав | Мин | Макс | Запас устойчивости | Что остаётся
D0. Первоочередное | ограждение и знаки, разборка аварийной площадки, лоток по краю двора с подключением водостоков и закрытым выпуском, простые геодезические наблюдения за марками | 1.6 | 2.9 | не меняется заметно; уменьшается приток воды с двора и крыш | склон остаётся аварийным
D. Неотложный этап: вода + данные | первоочередное + доизыскания, перехватывающий дренаж вдоль двора, датчики сдвига и уровня воды, наблюдения 2 года | 7.9 | 13.6 | весной запас не опускается до 0,83–0,97, остаётся ≈ 0,90–1,01 | ниже нормы 1,15; зато появляются данные для уменьшения объёма рёбер
C. Без подземных рёбер (вариант 1 ПЗ) | неотложный этап + разборка стен, срезка и берма, горизонтальные дрены, габионы и матрацы у воды, откосы | 25.1 | 41.4 | 1,00–1,05 | ниже нормы 1,15: риск оползня снижается, но не устраняется
B. Первая очередь: участок у дома ≈ 42 м | полный набор работ только на аварийном участке (разрезы А-А и Г-Г) | 43.3 | 69.7 | 1,25–1,27 на участке у дома | участки II–III (≈ 57 м) остаются с запасом 1,00–1,01
A. Полная защита всего склона ≈ 100 м | все работы проекта по всему фронту | 87.6 | 139.3 | 1,25–1,31 (при землетрясении 7 баллов 1,09–1,13) | норма выполняется
