UrryUrr/ushayka-sklon-3d/(list of files, cad)

Other CAD files:
docs/Plan_razrezy_MSK70.dxf
