UrryUrr/ushayka-sklon-3d/docs/Chertezhi_2026-MOS40-IZ.pdf

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

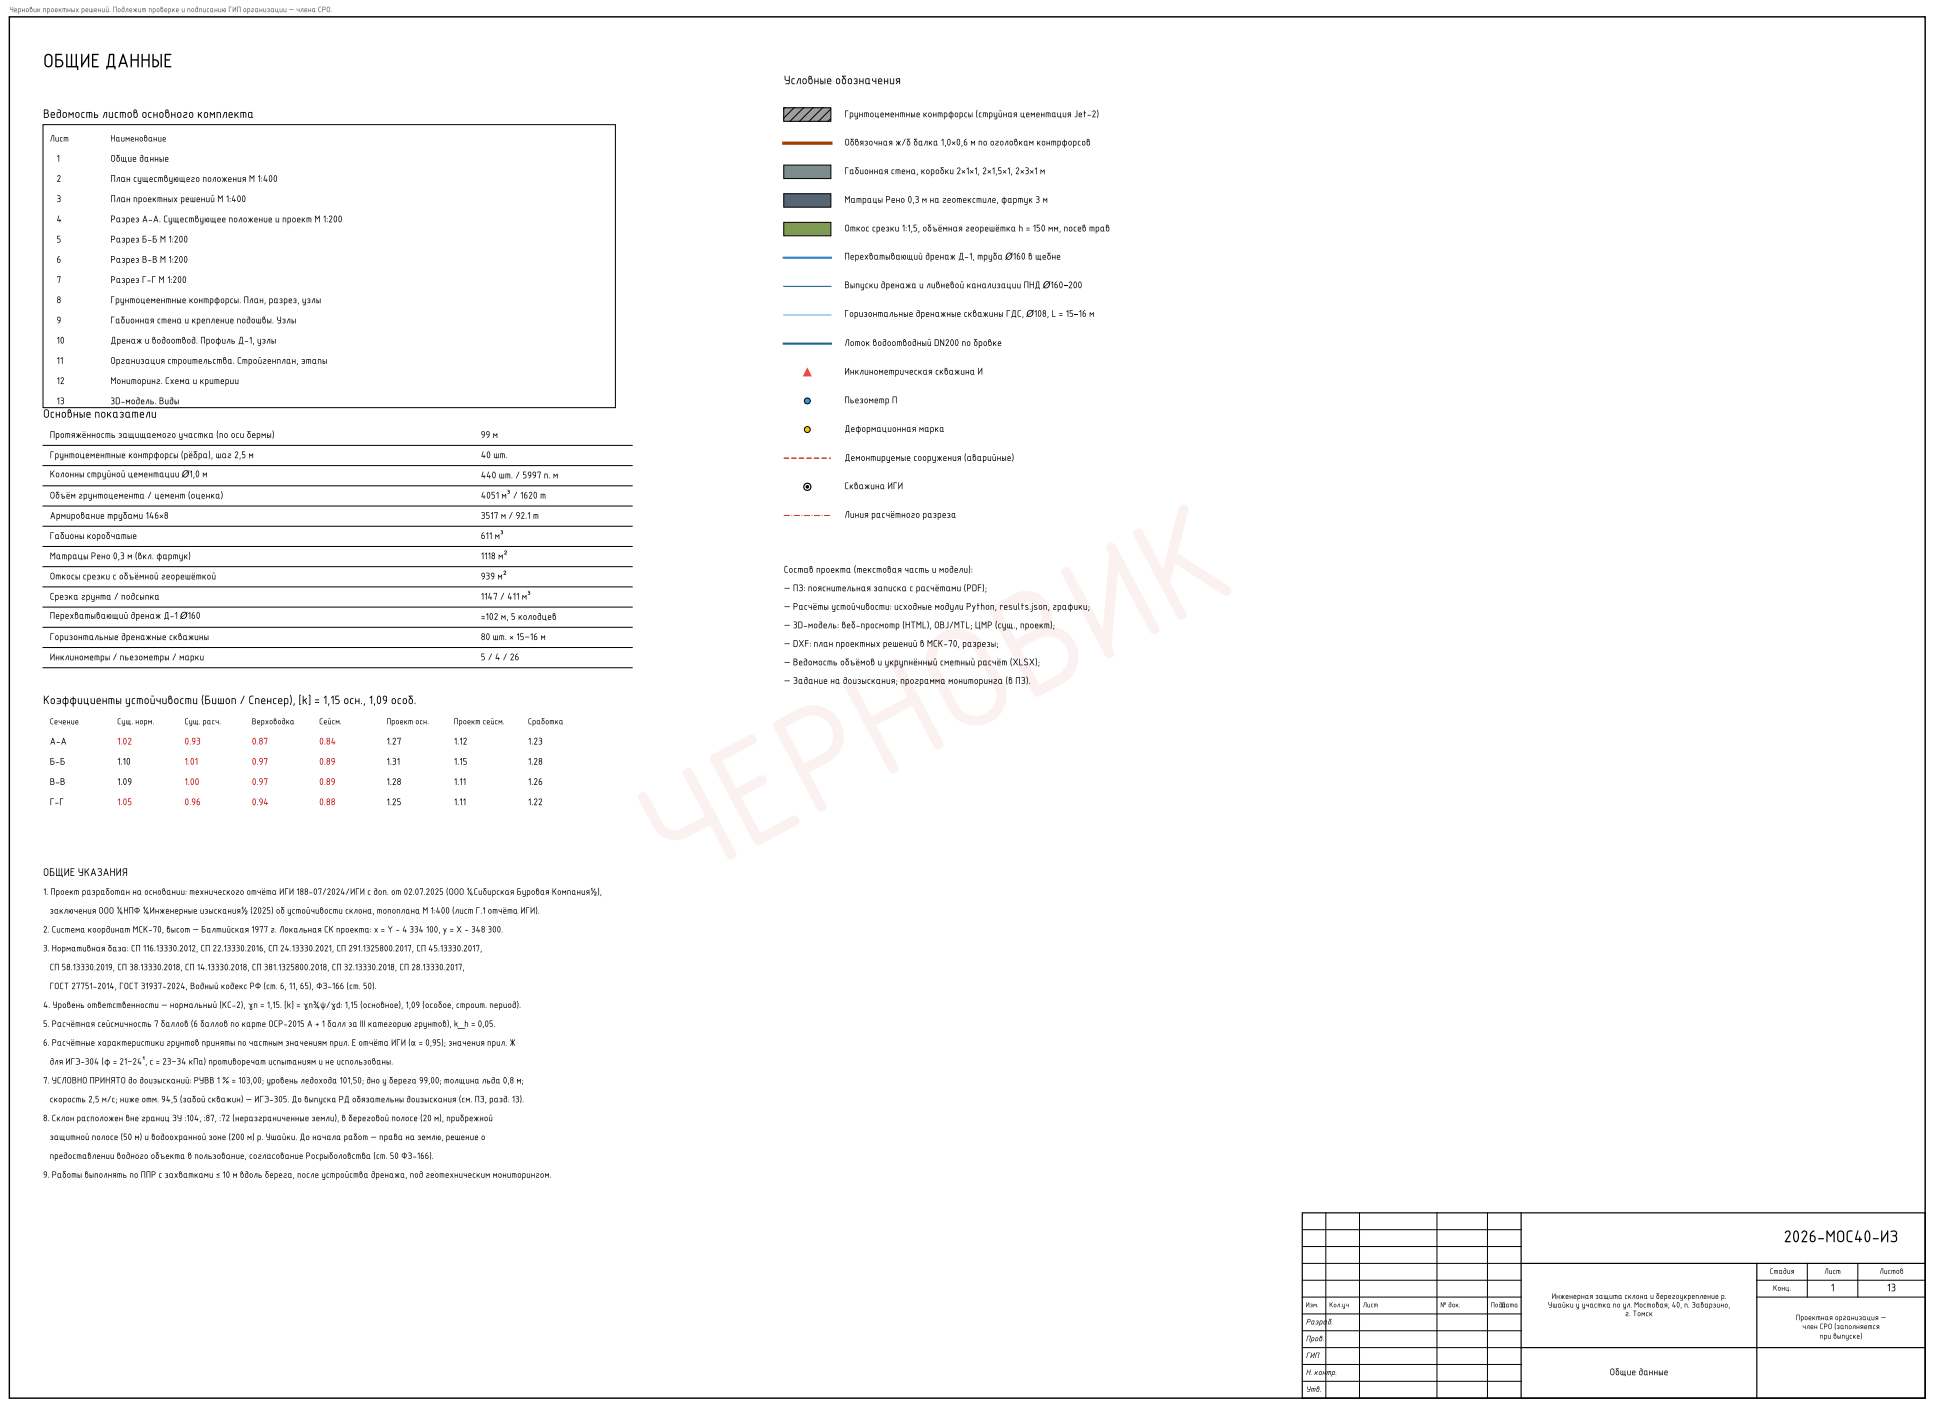
[picture p39: page 1]

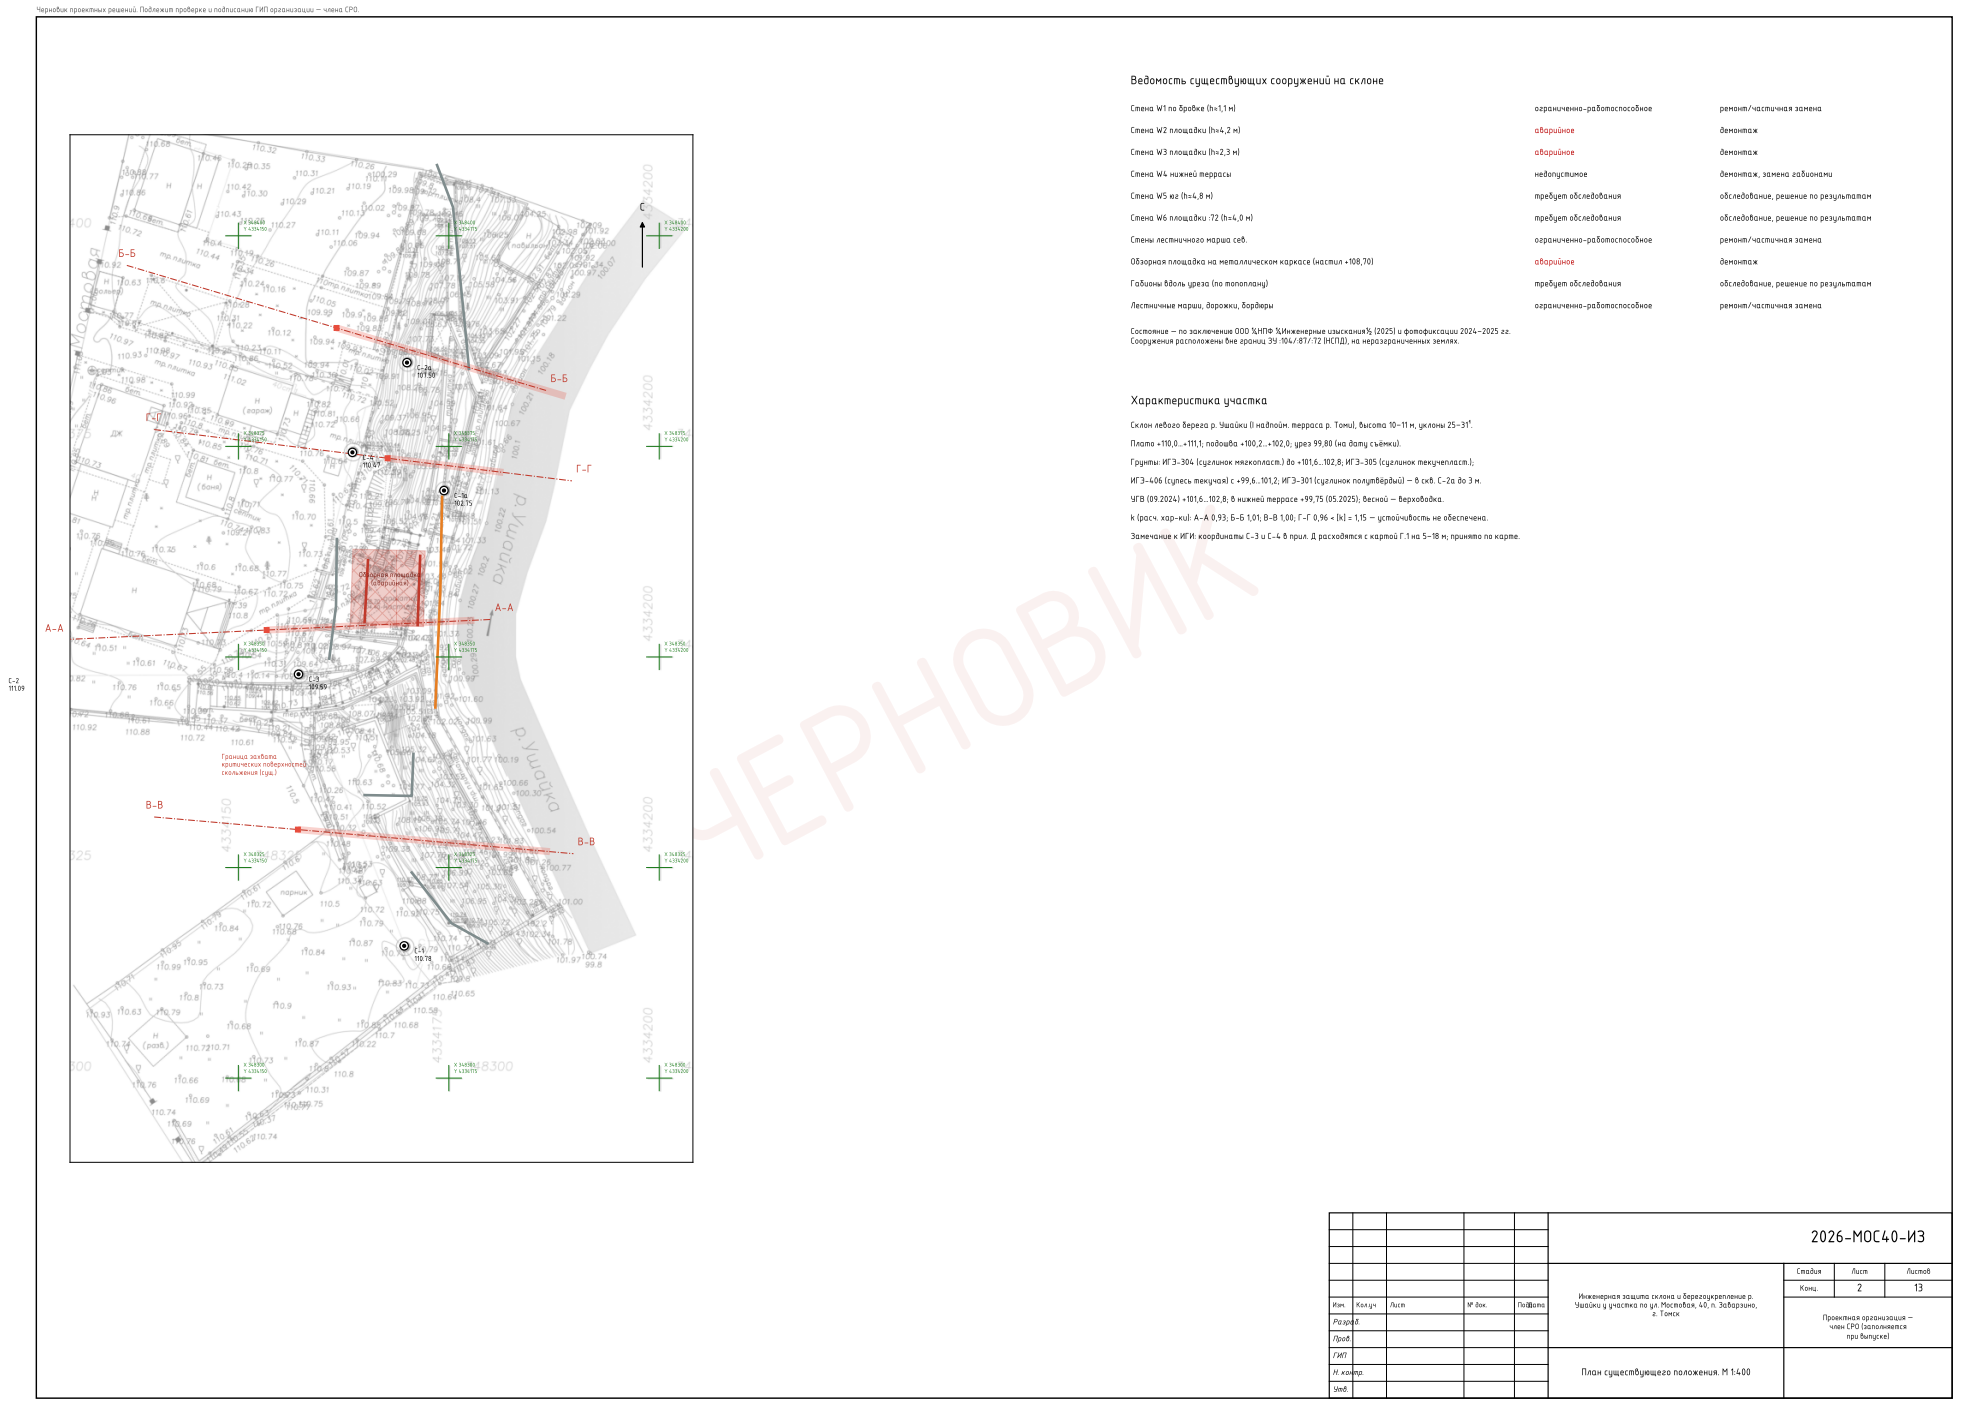
[picture p40: page 2]

/ | ( | -70)

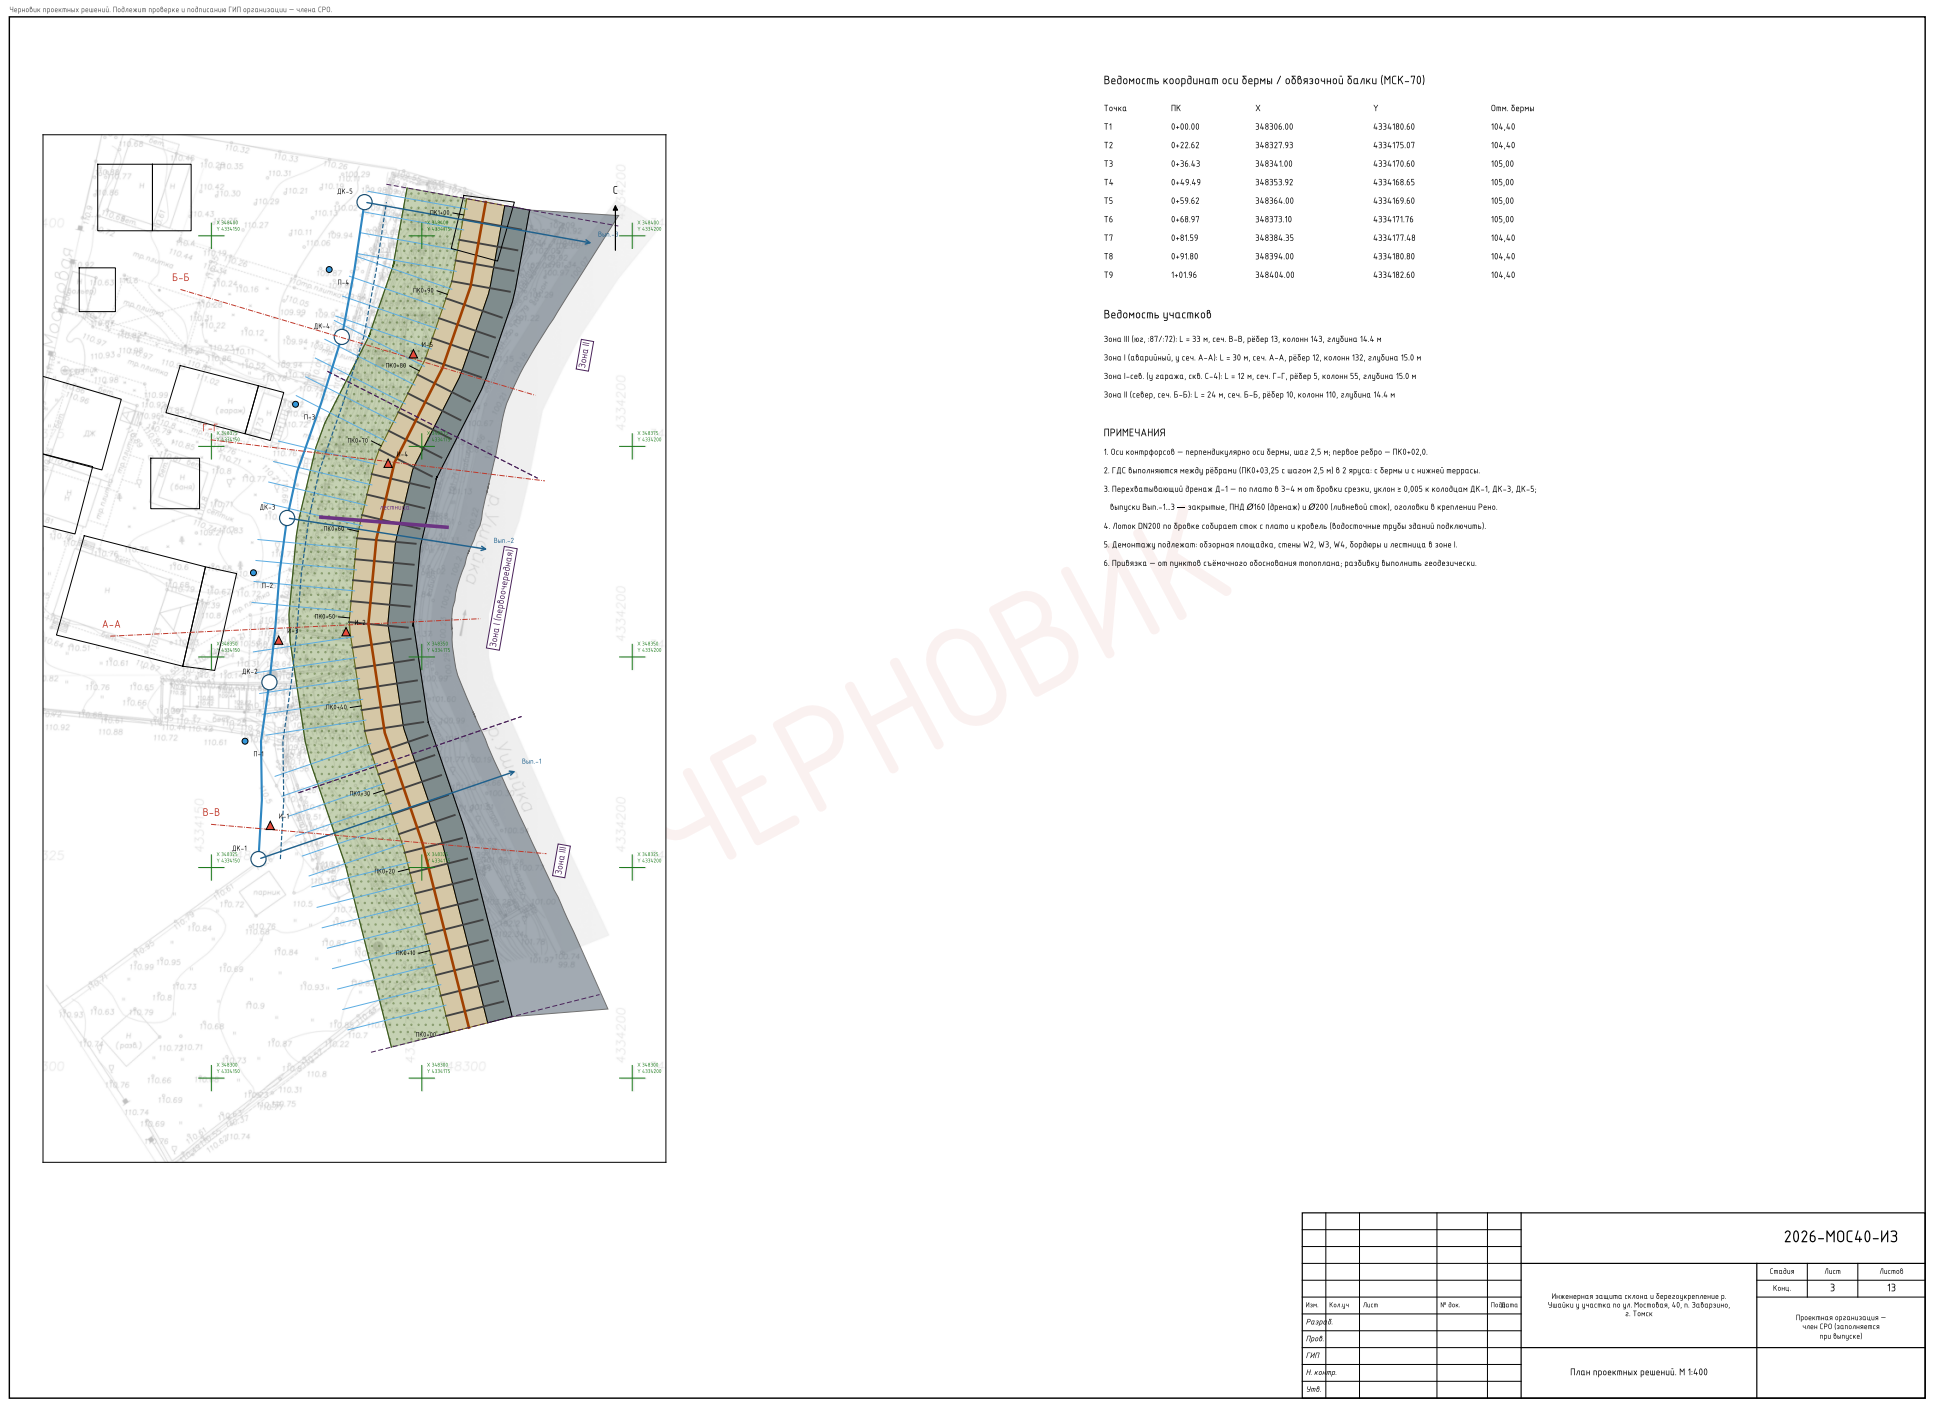
[picture p41: page 3]
III ( , :87/:72): L = 33 ,; III

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

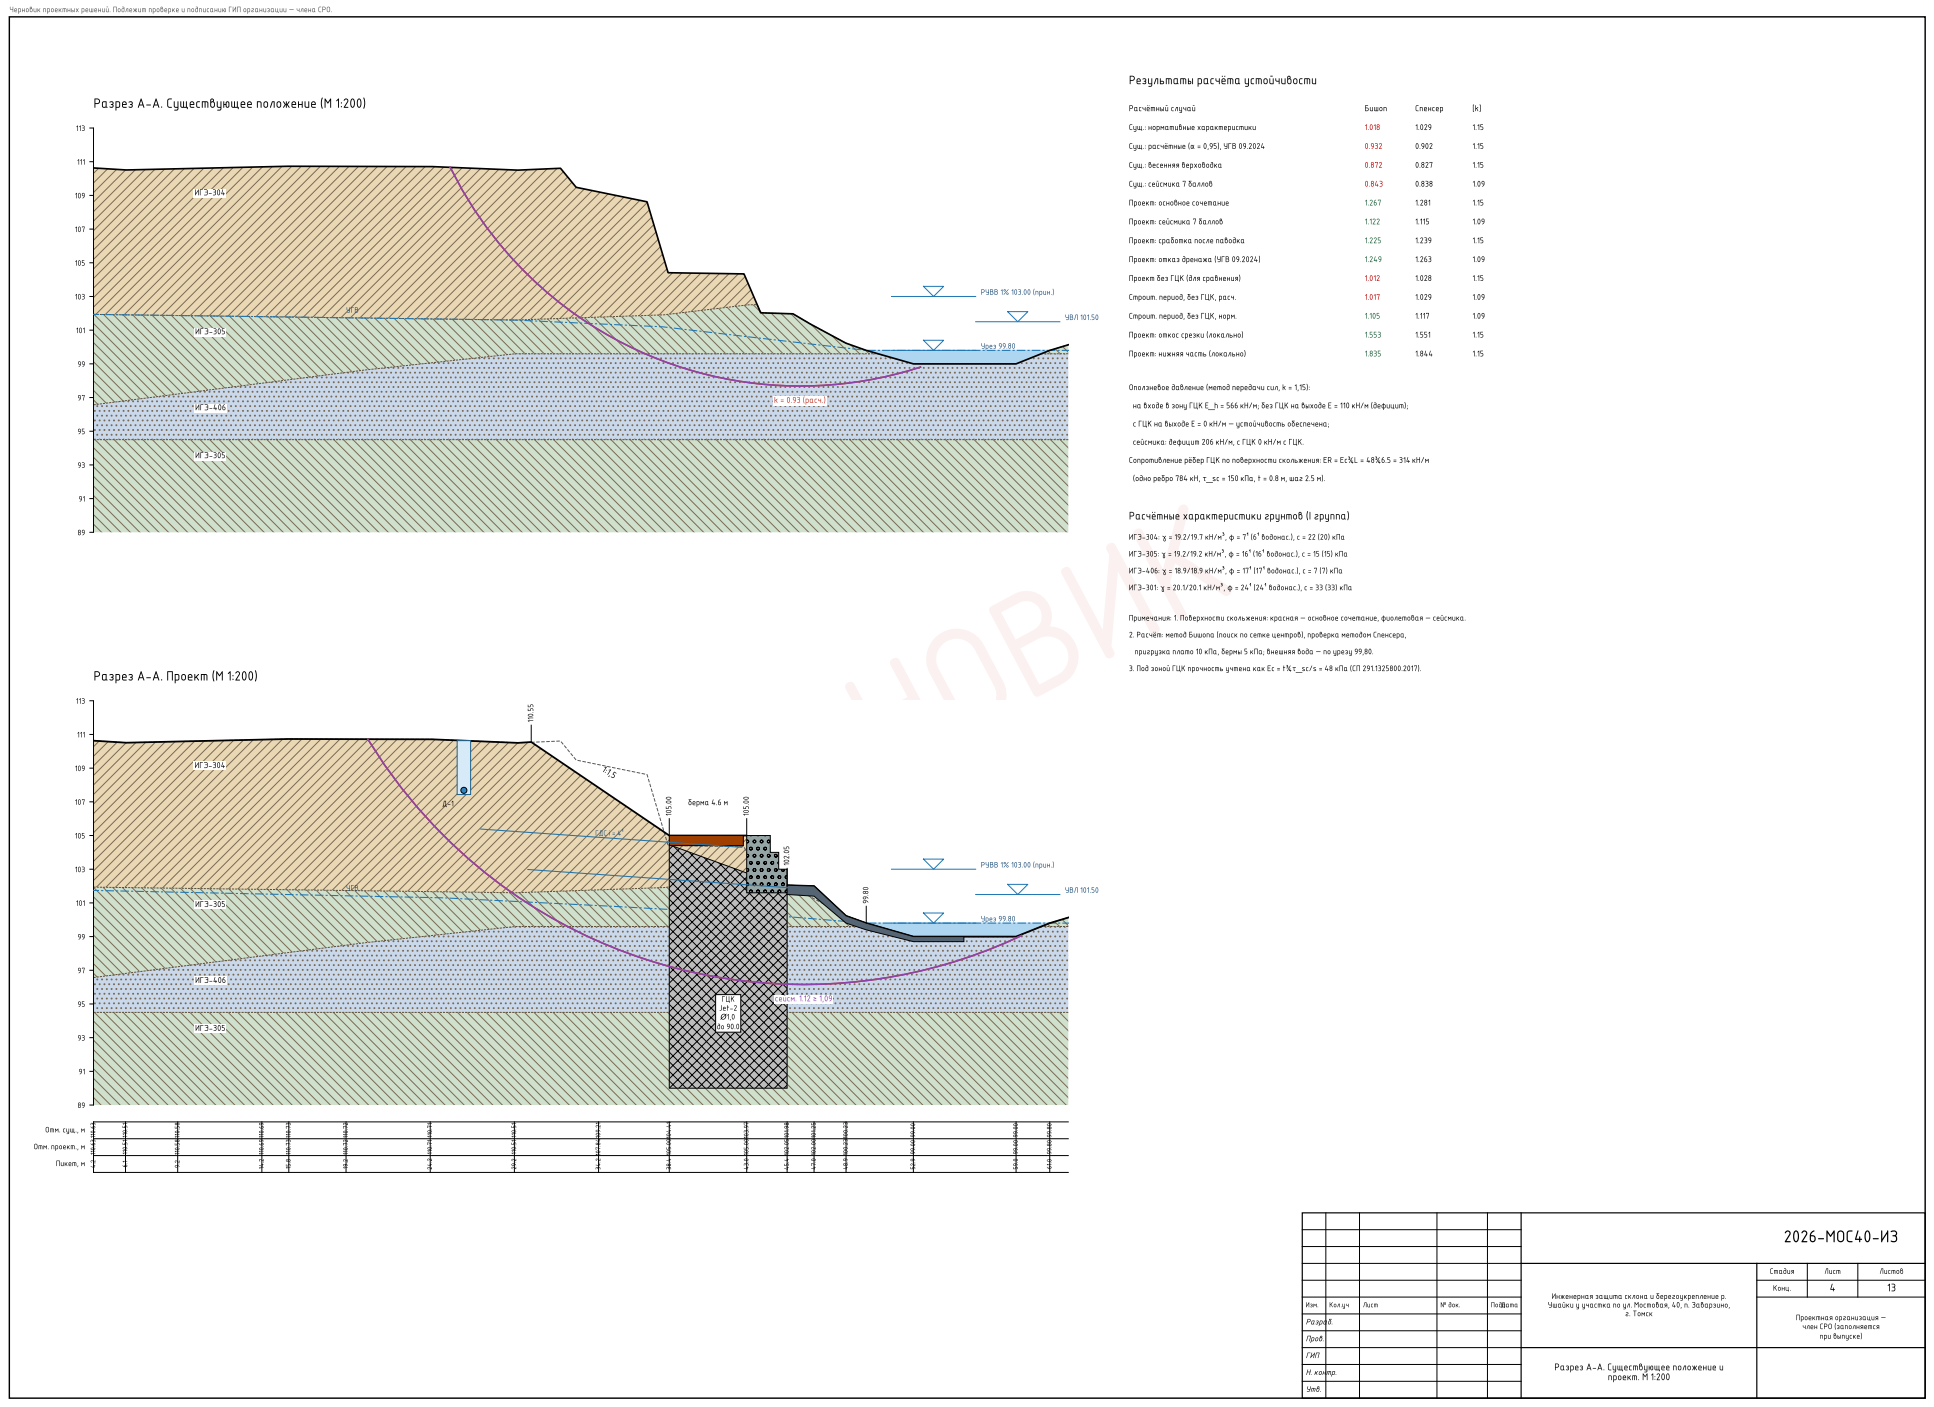
[picture p42: page 4]

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

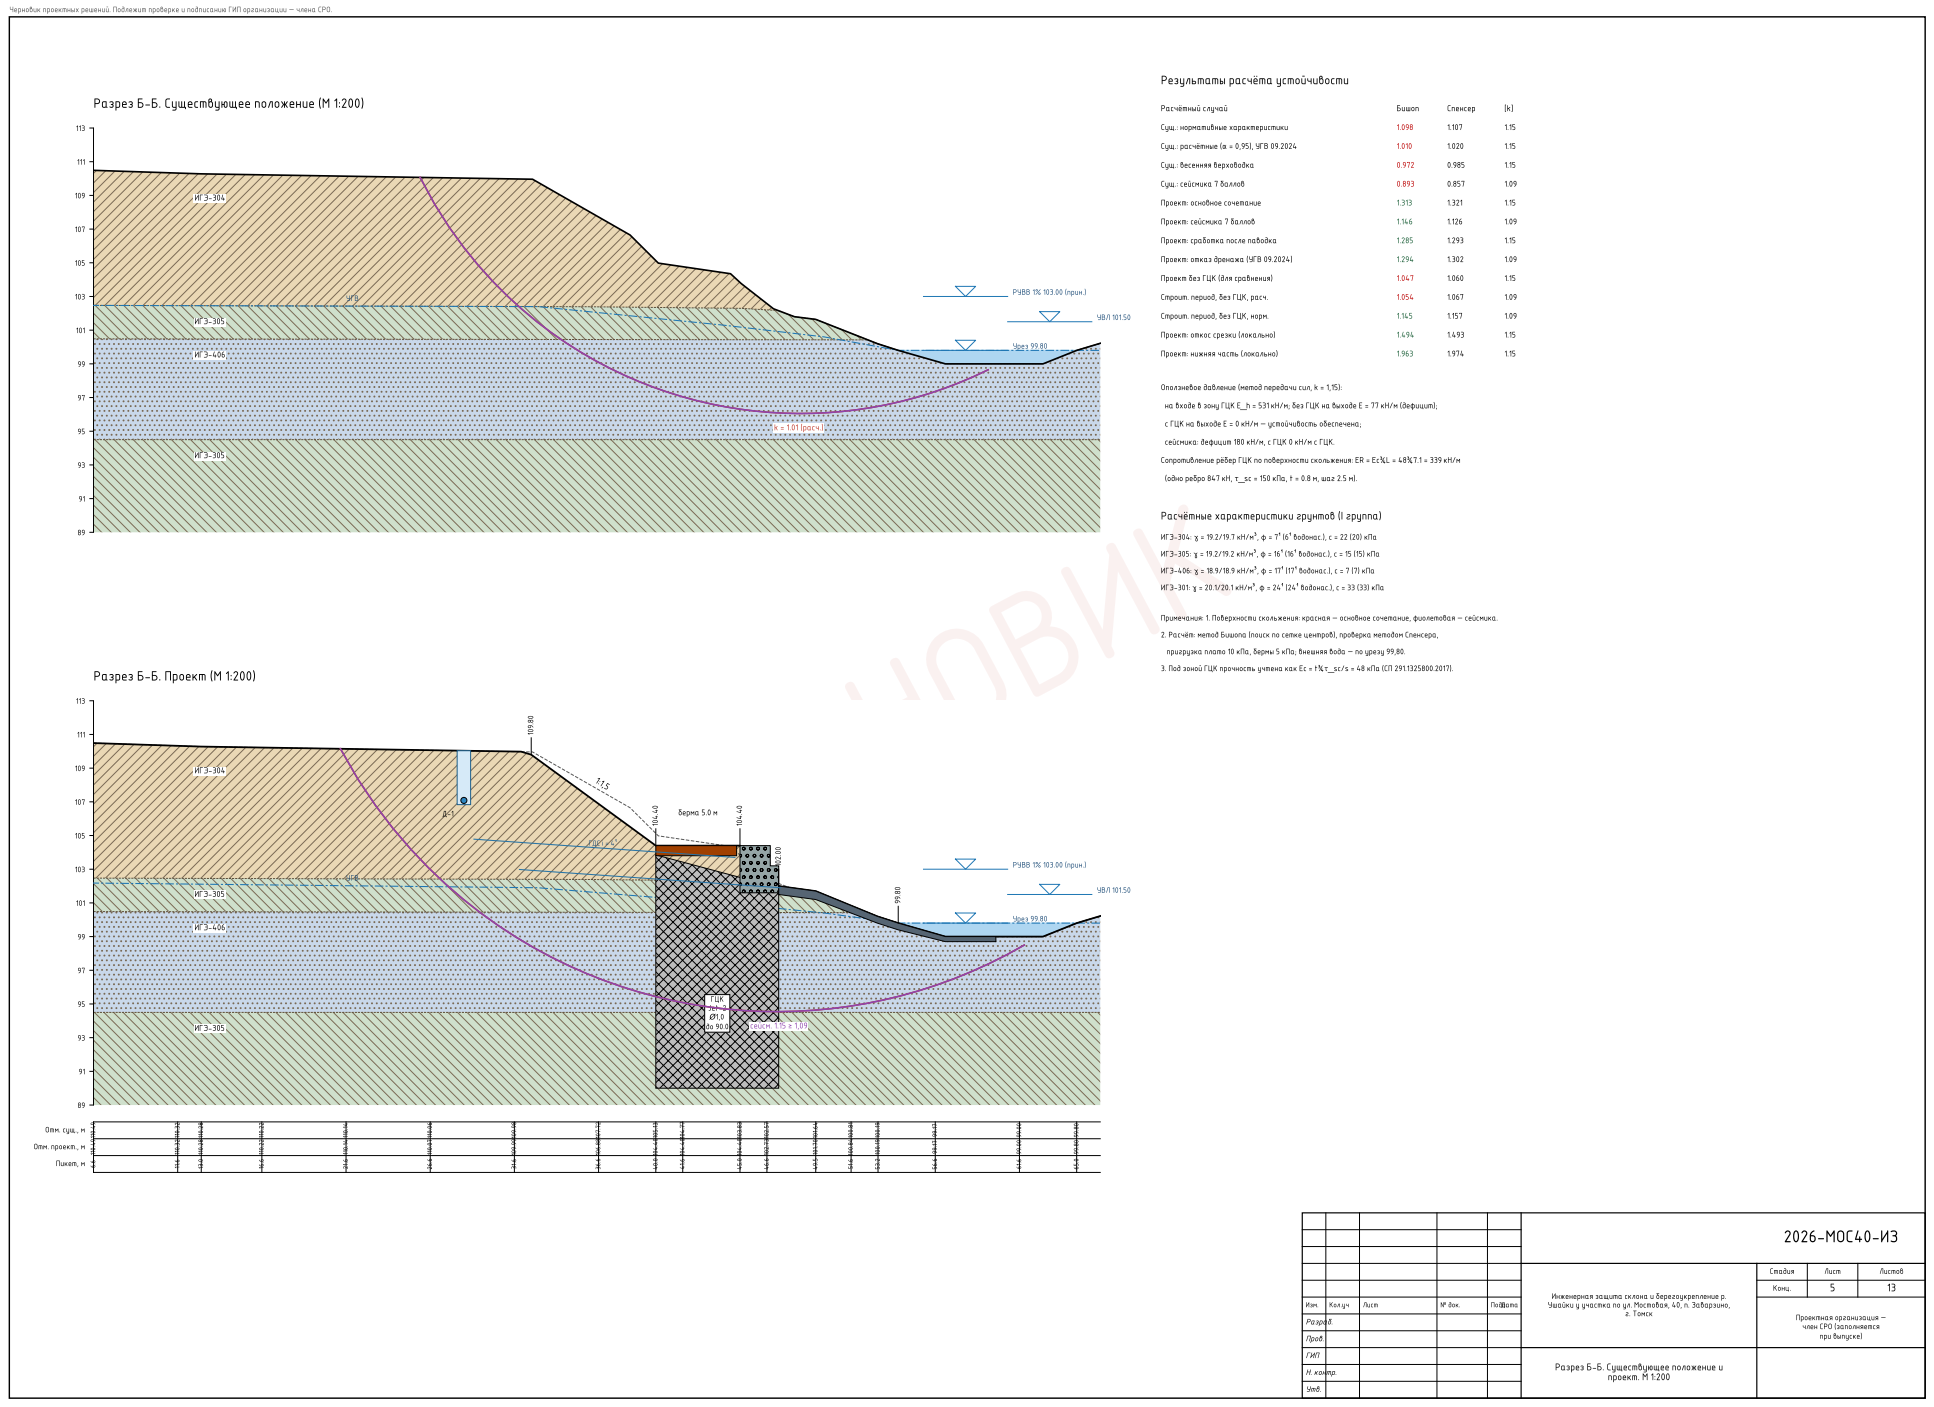
[picture p43: page 5]

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

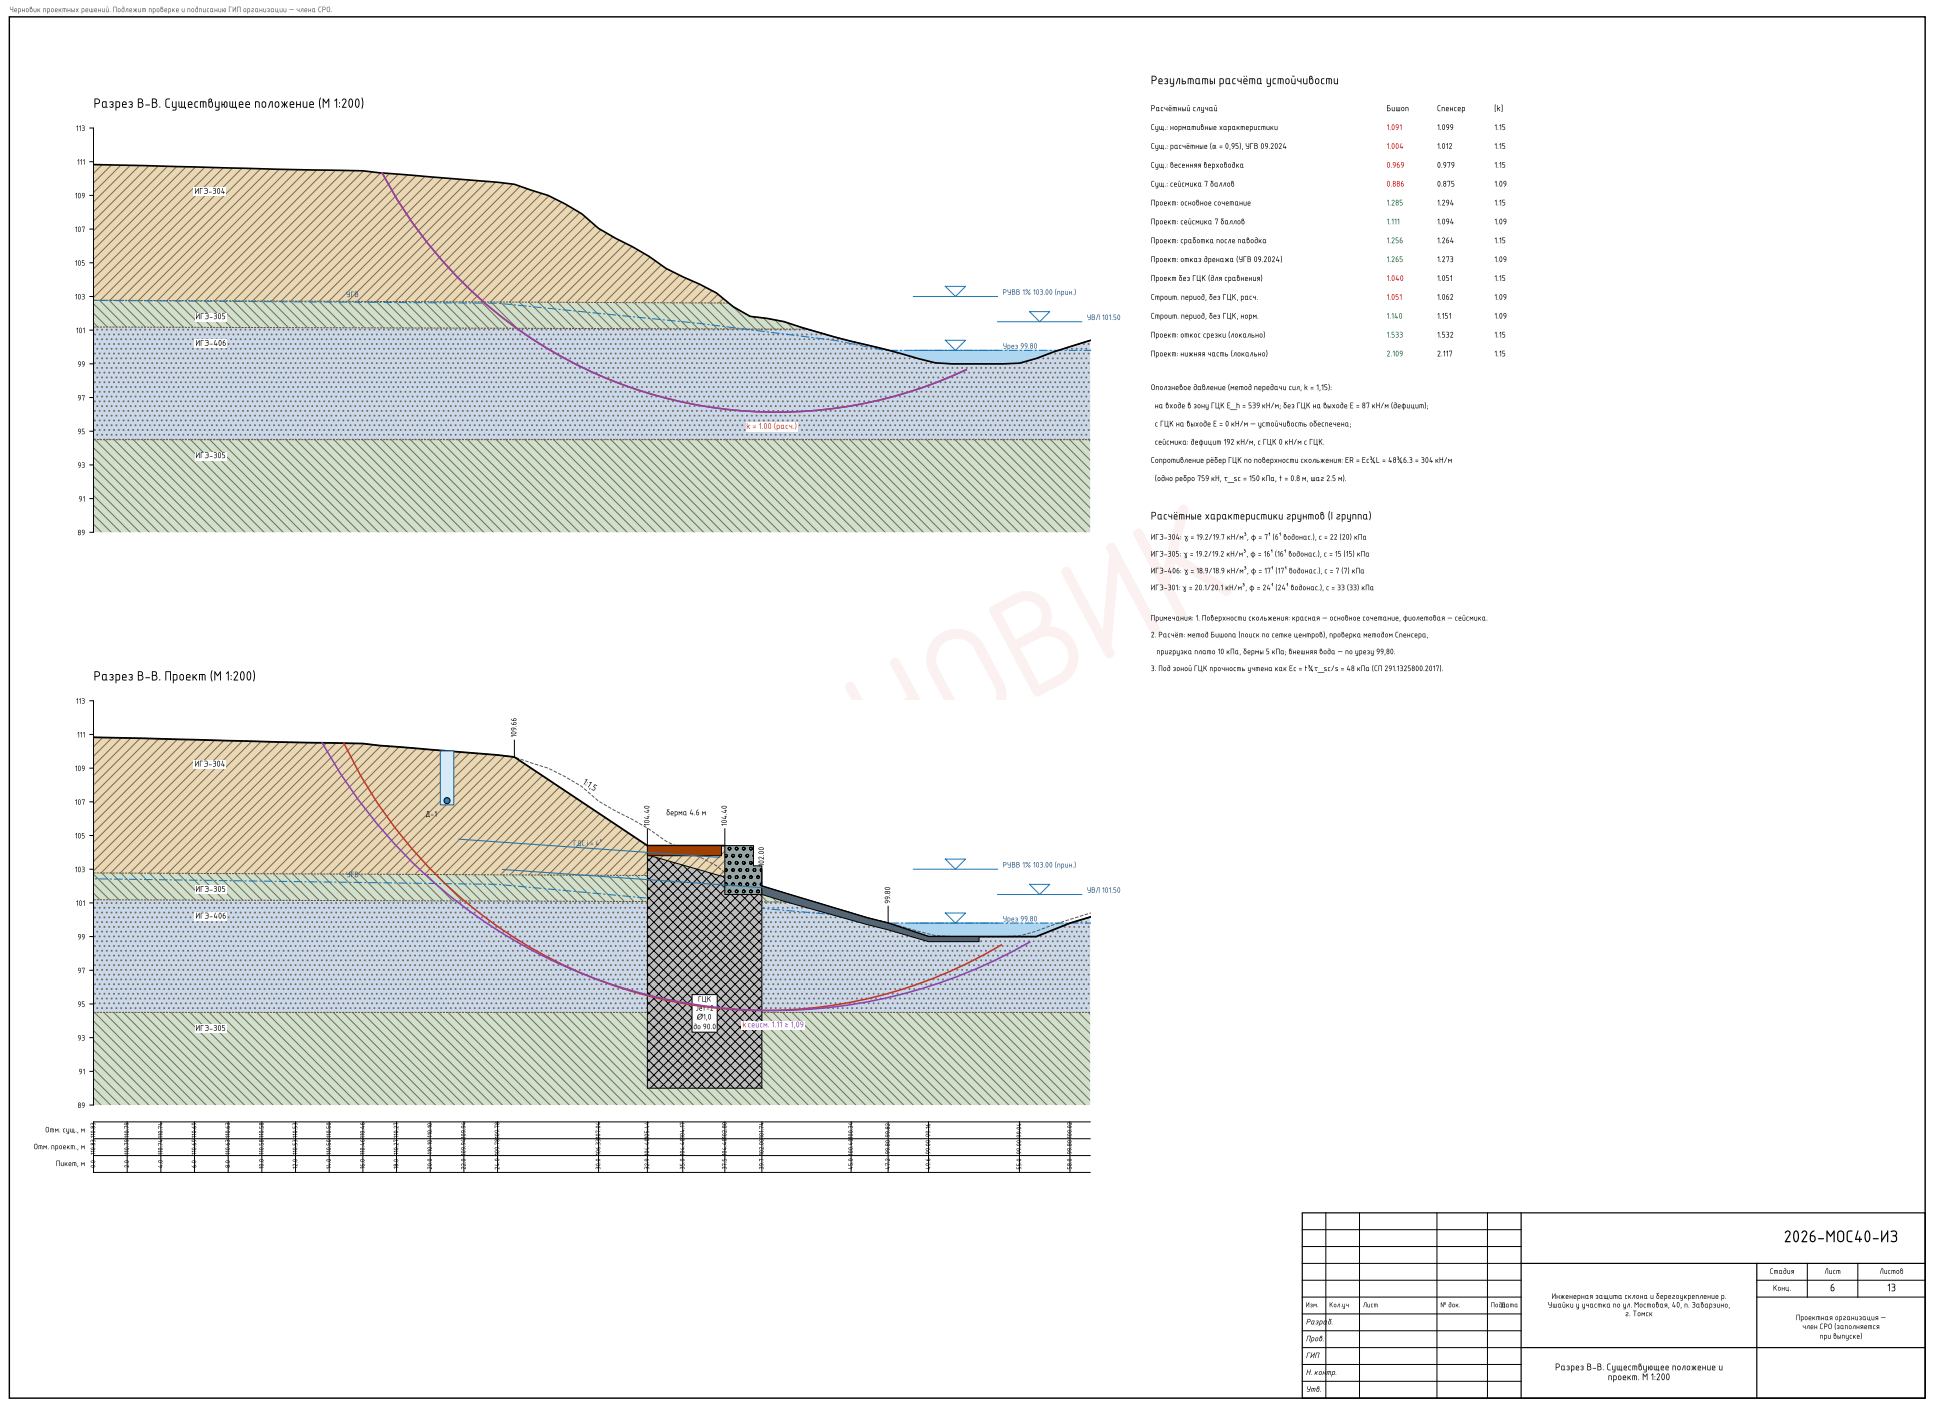
[picture p44: page 6]

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

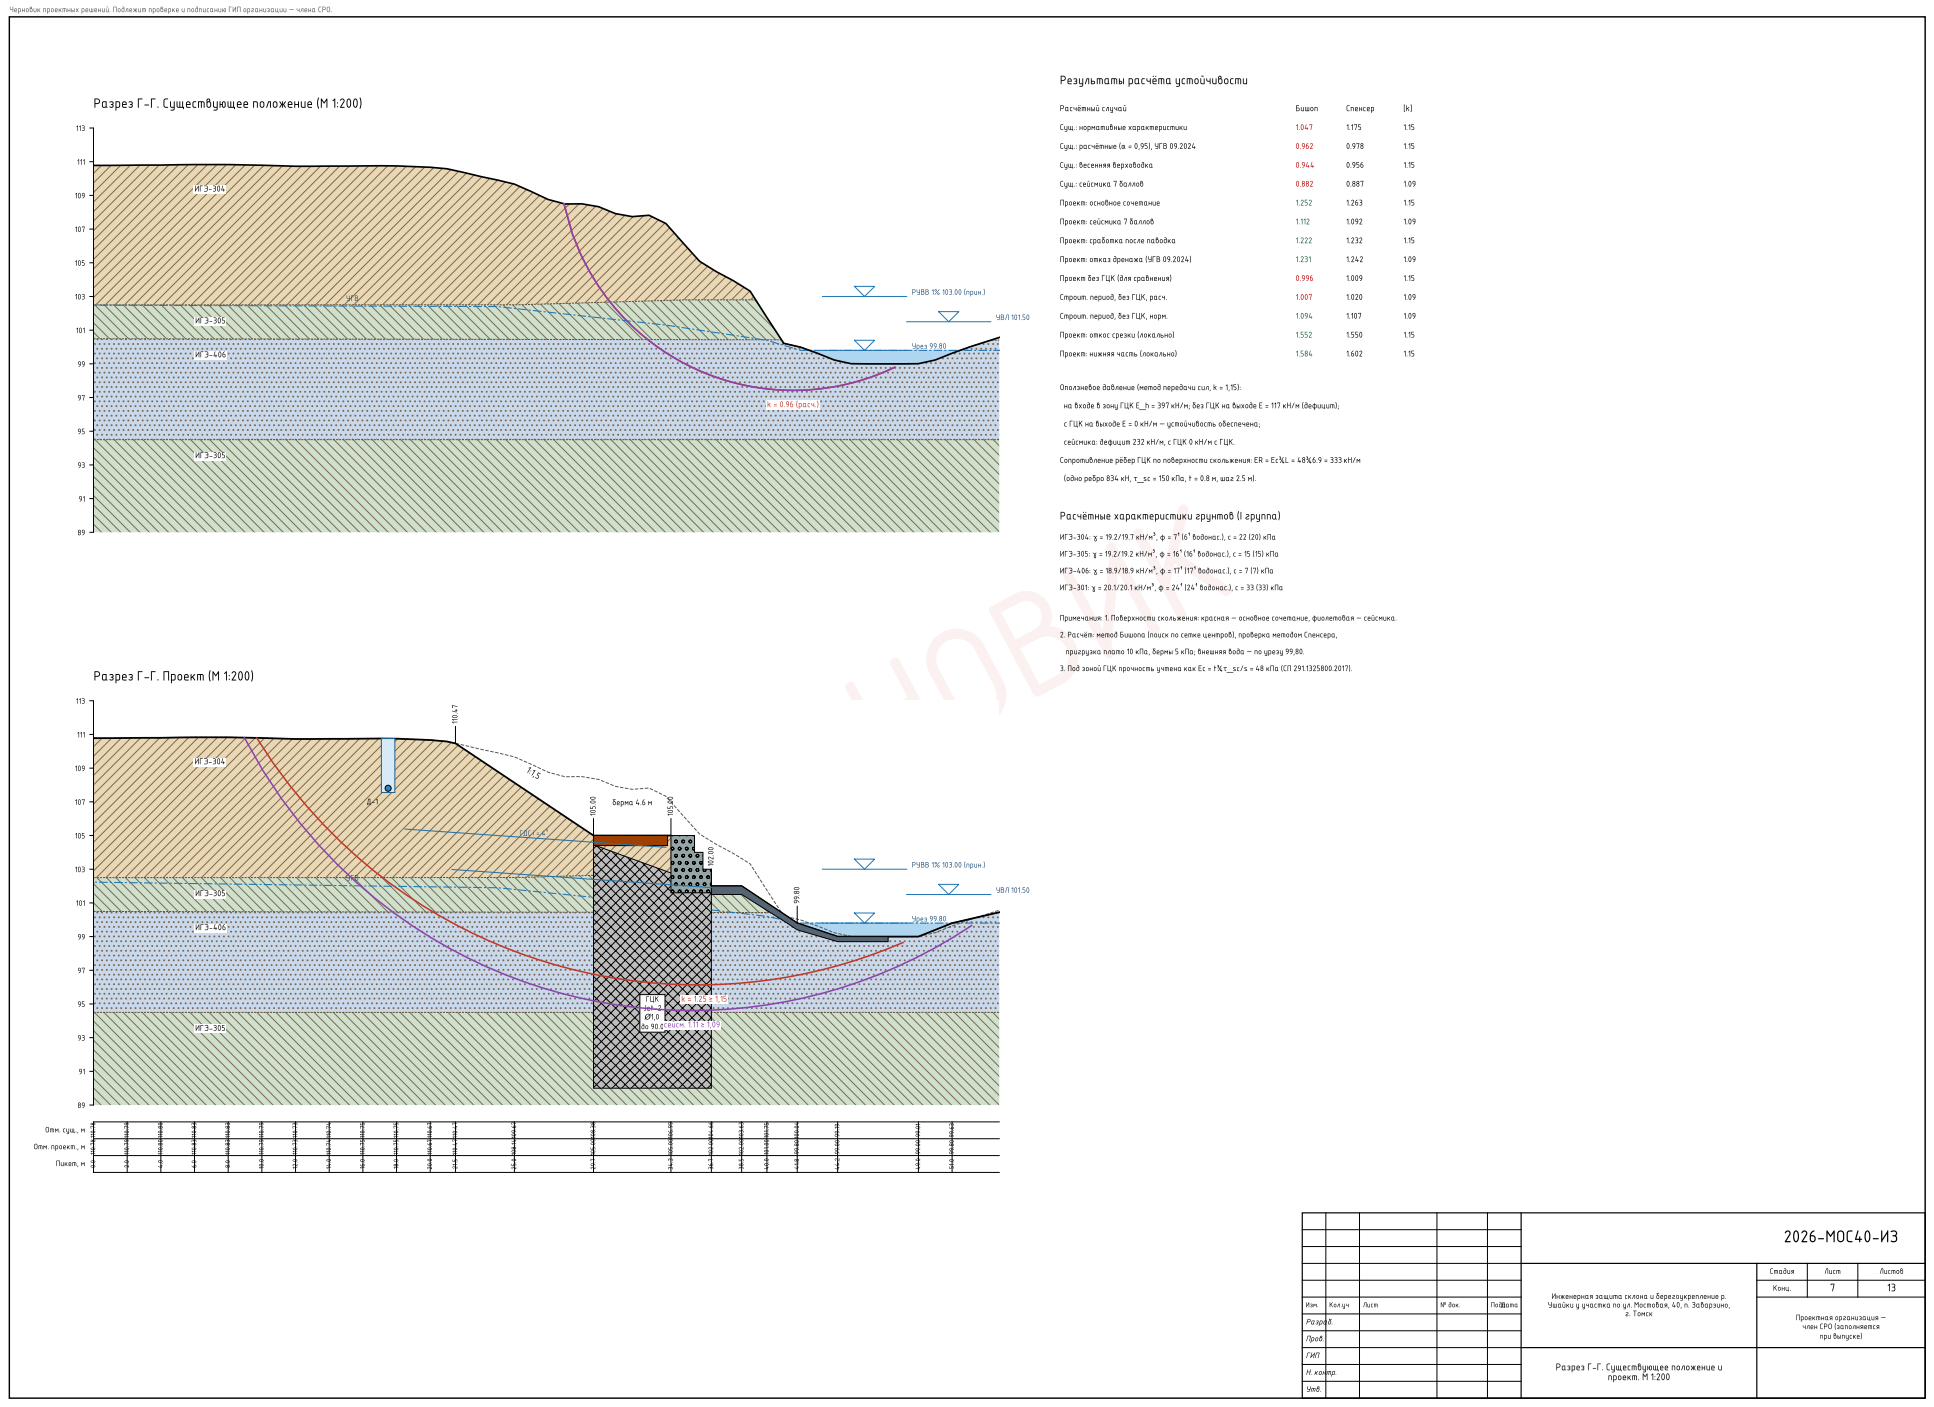
[picture p45: page 7]

( 1:100)

( | . - , | 1:100)

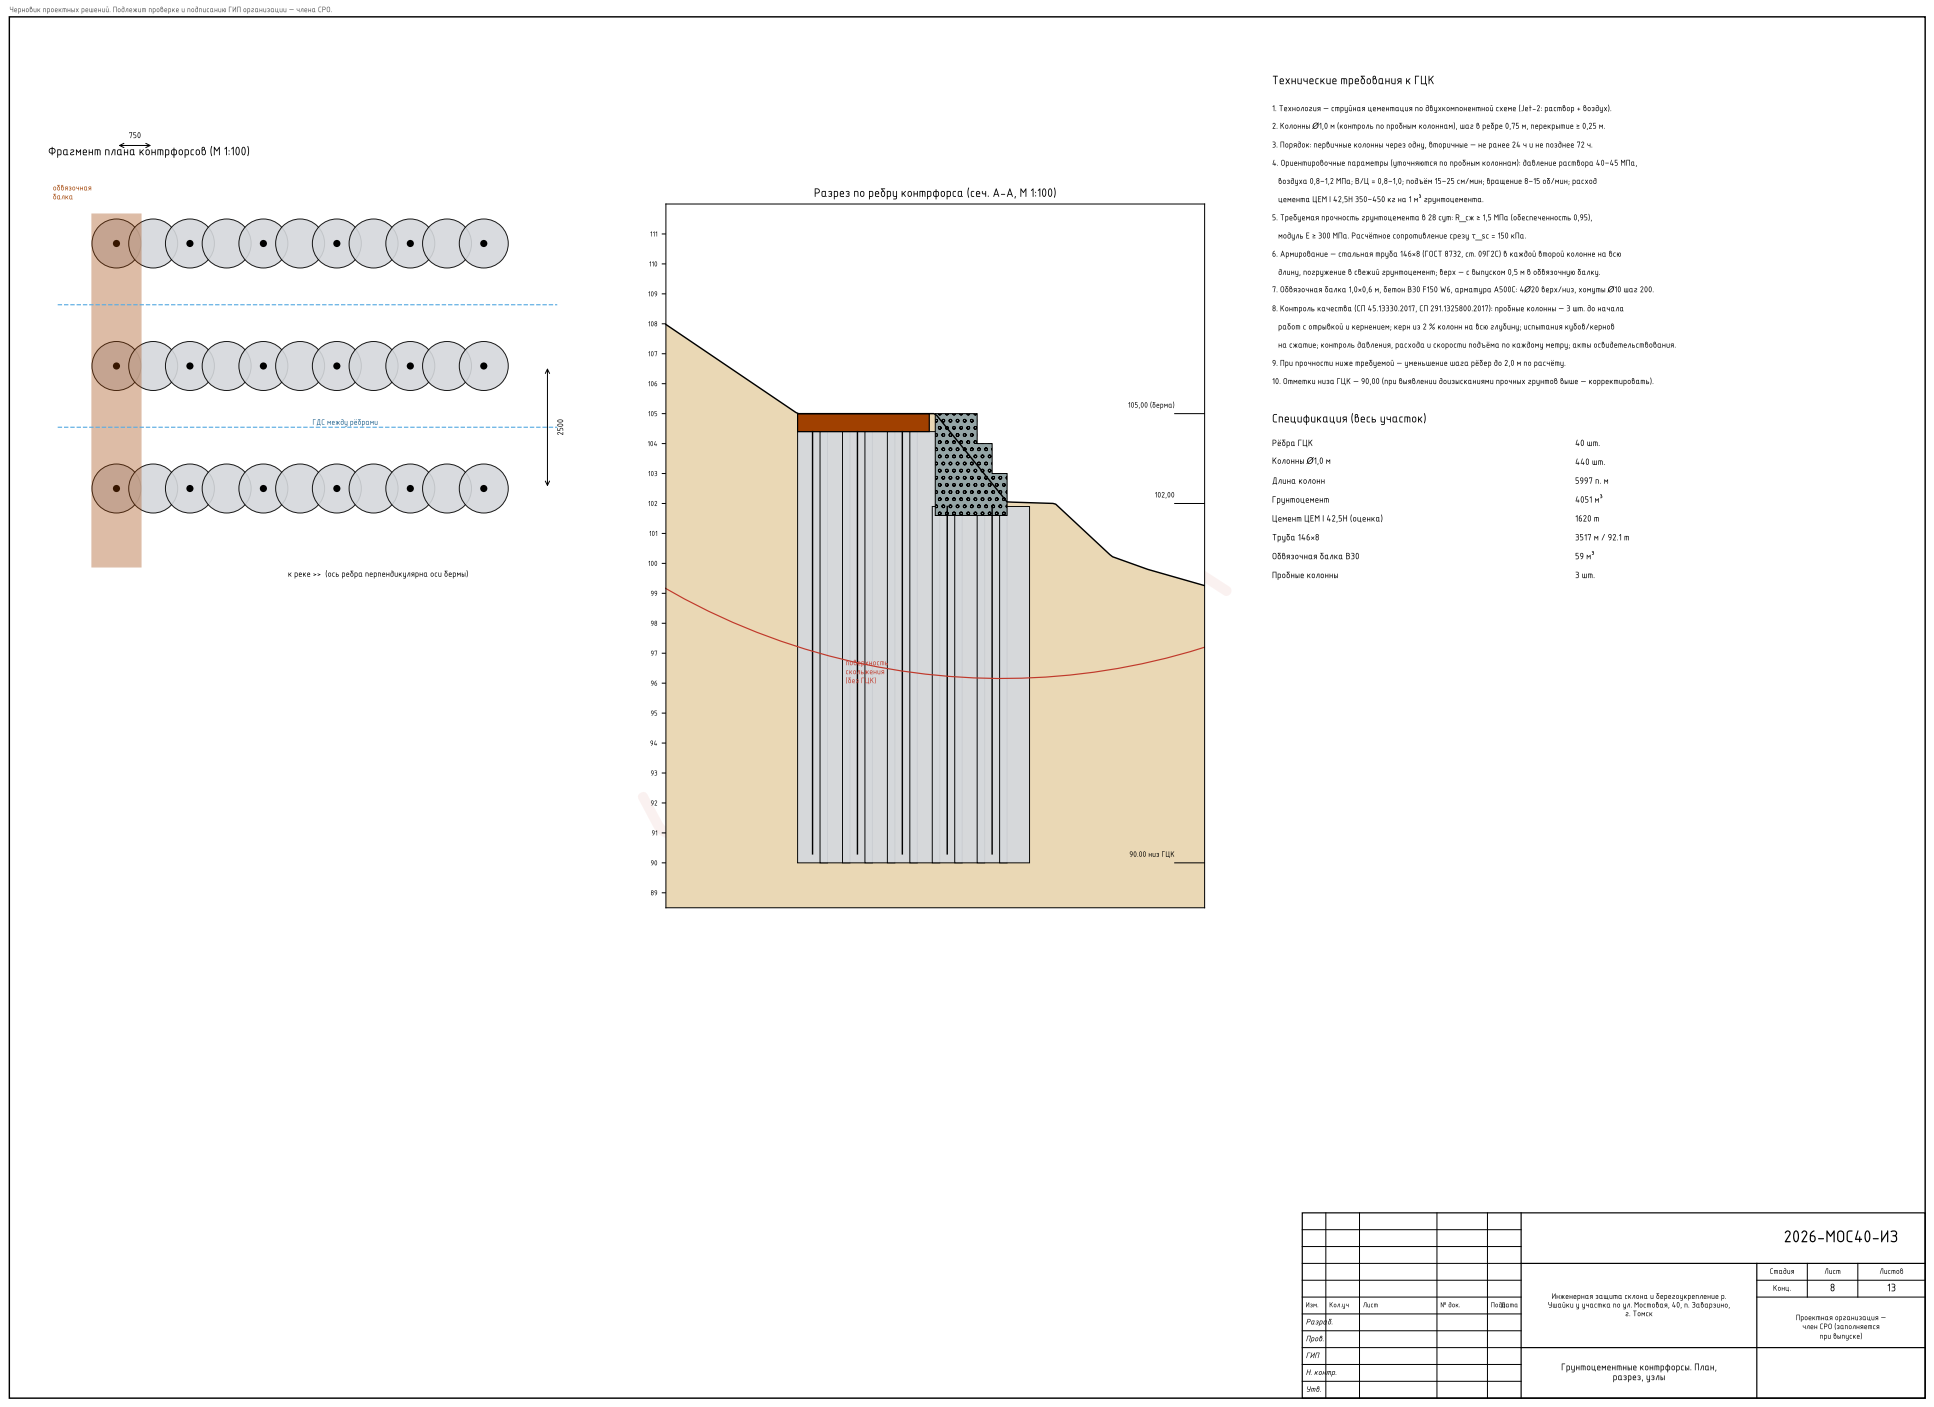
[picture p46: page 8]
(Jet-2:

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

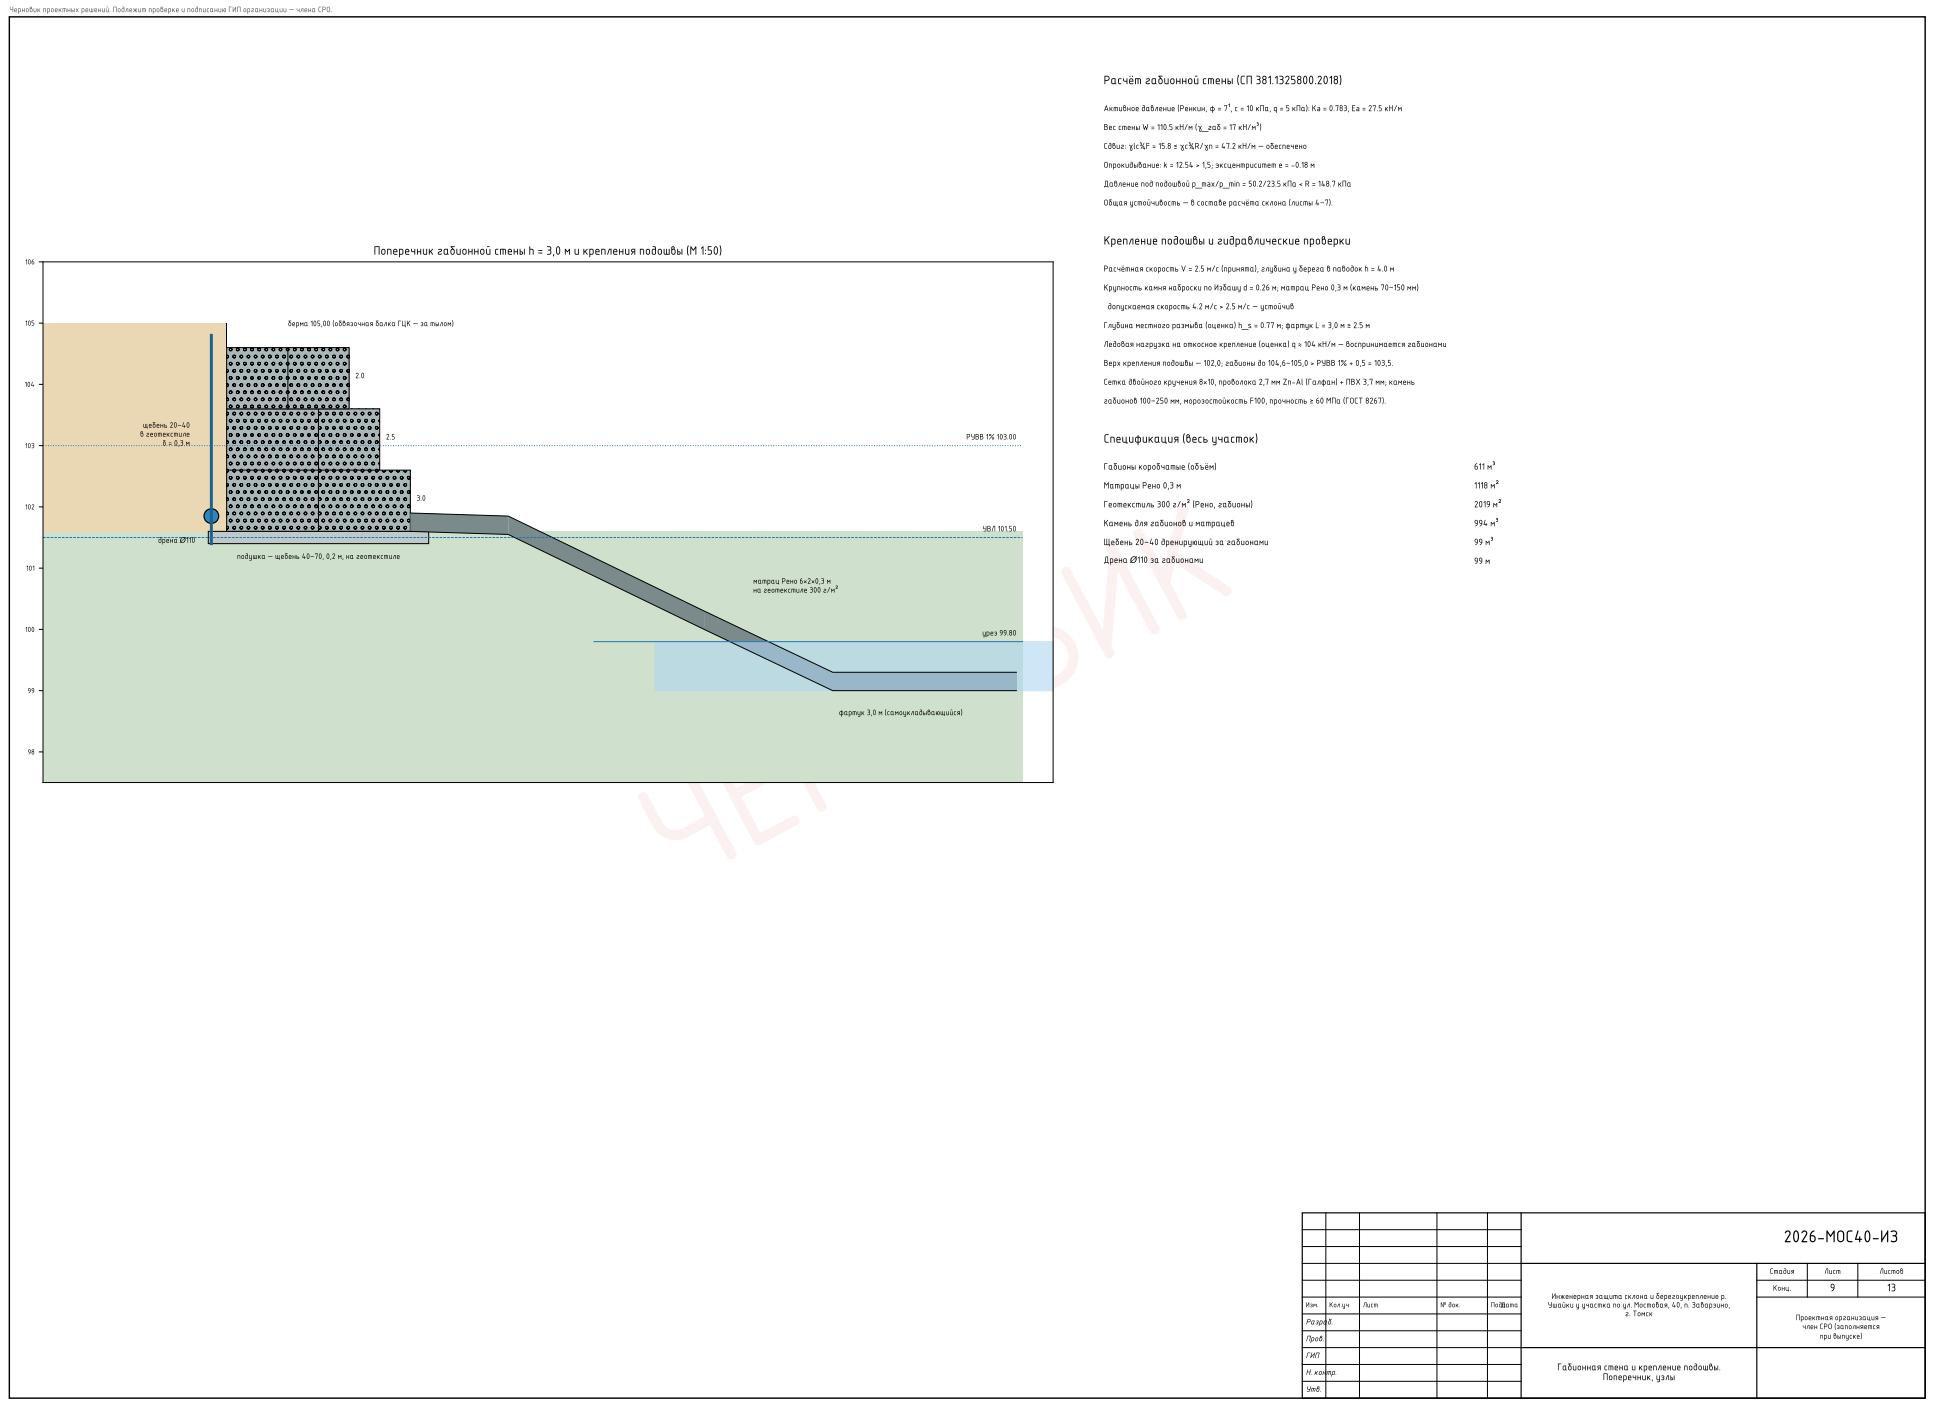
[picture p47: page 9]

-1 ( | . 1:500, | . 1:50)

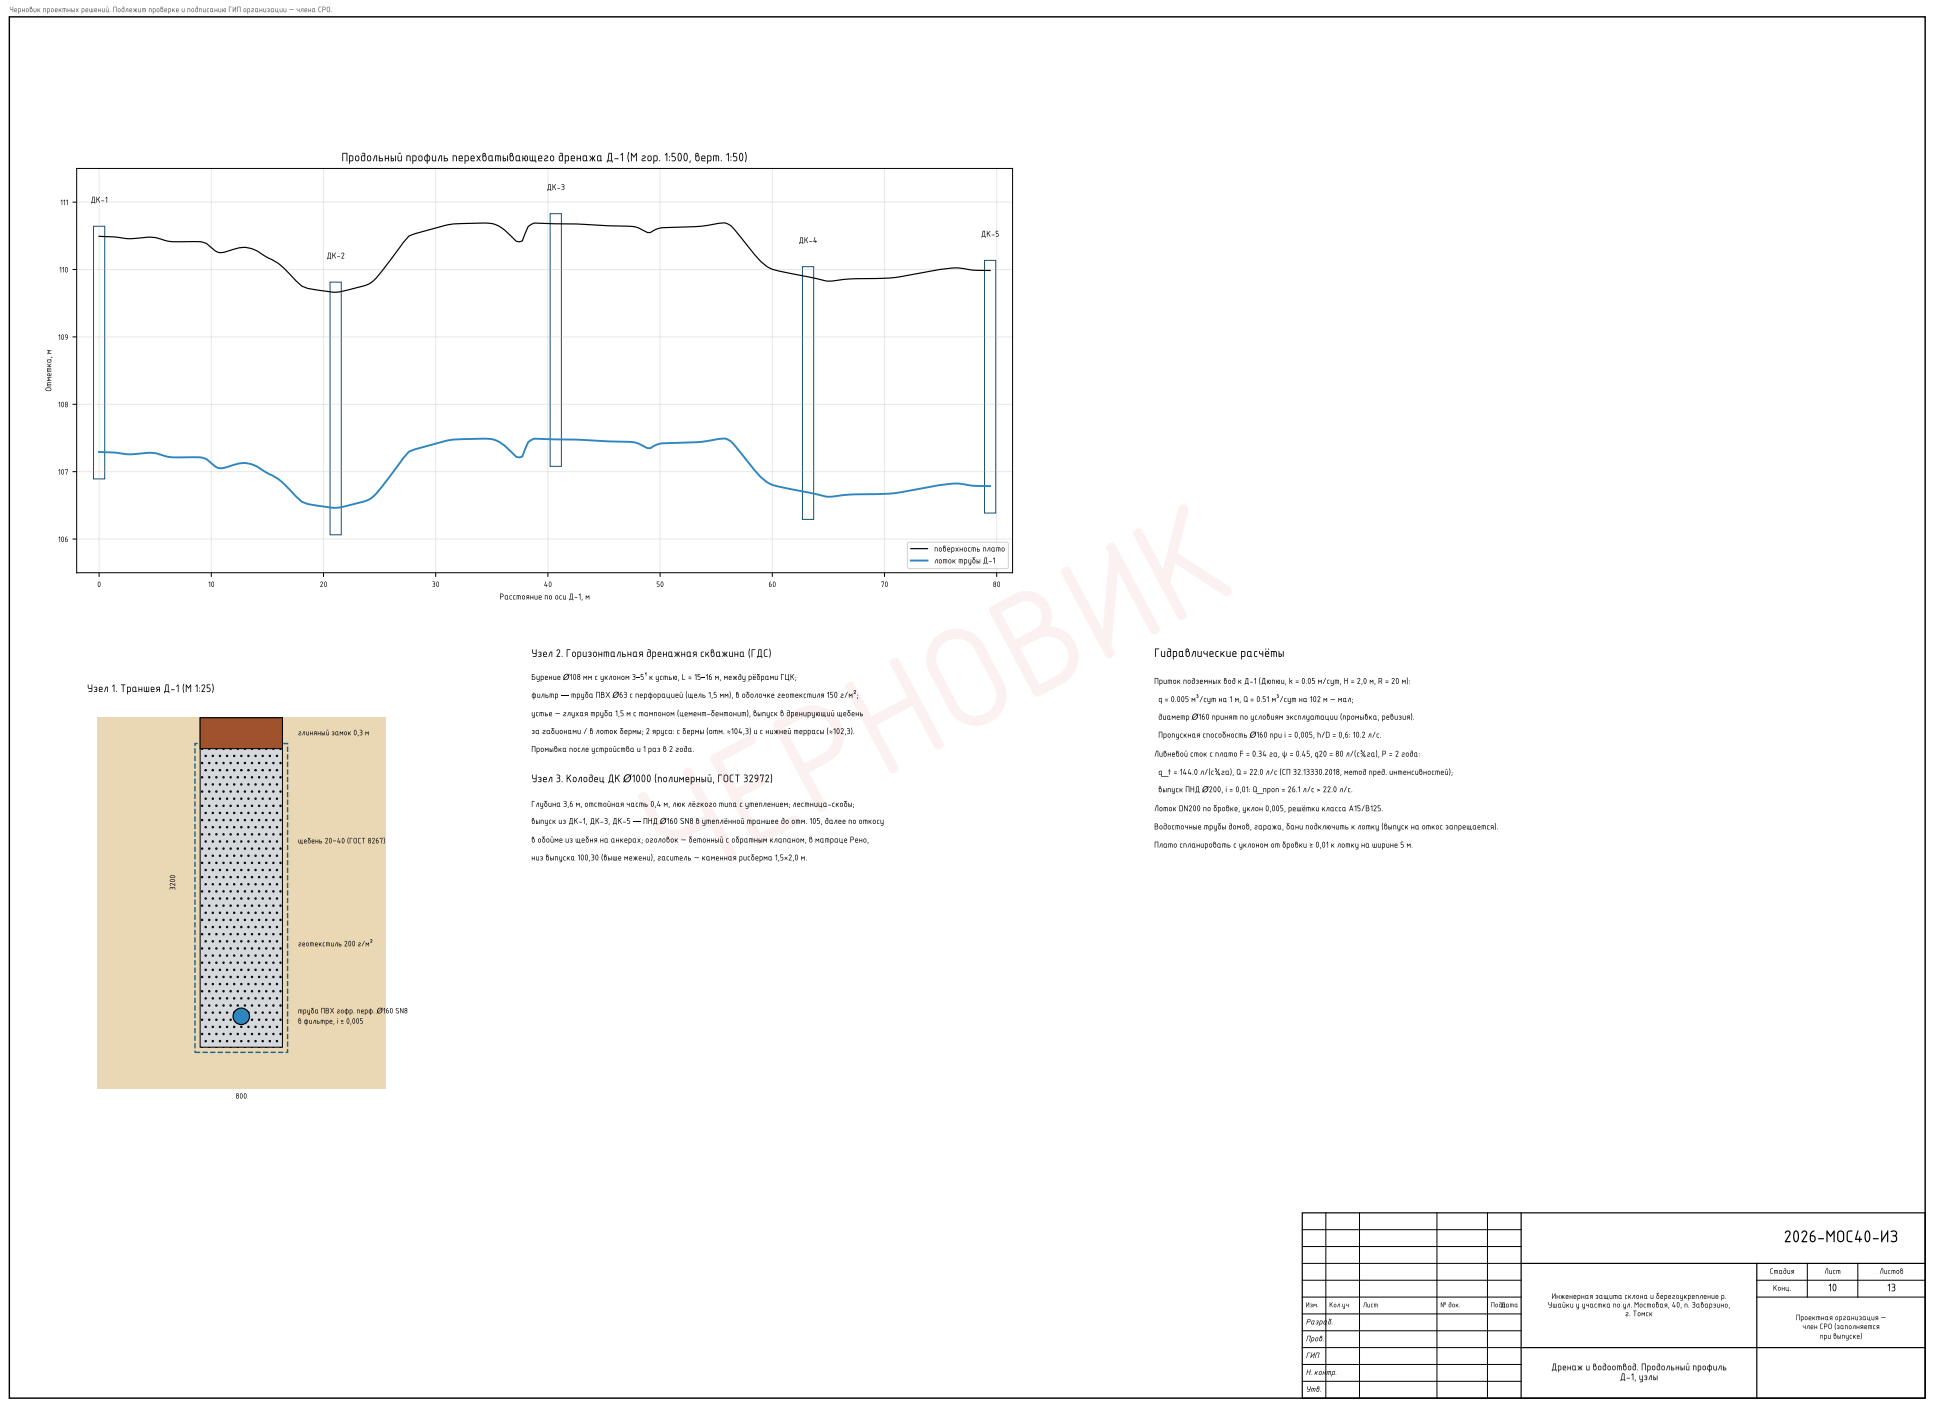
[picture p48: page 10]

( )

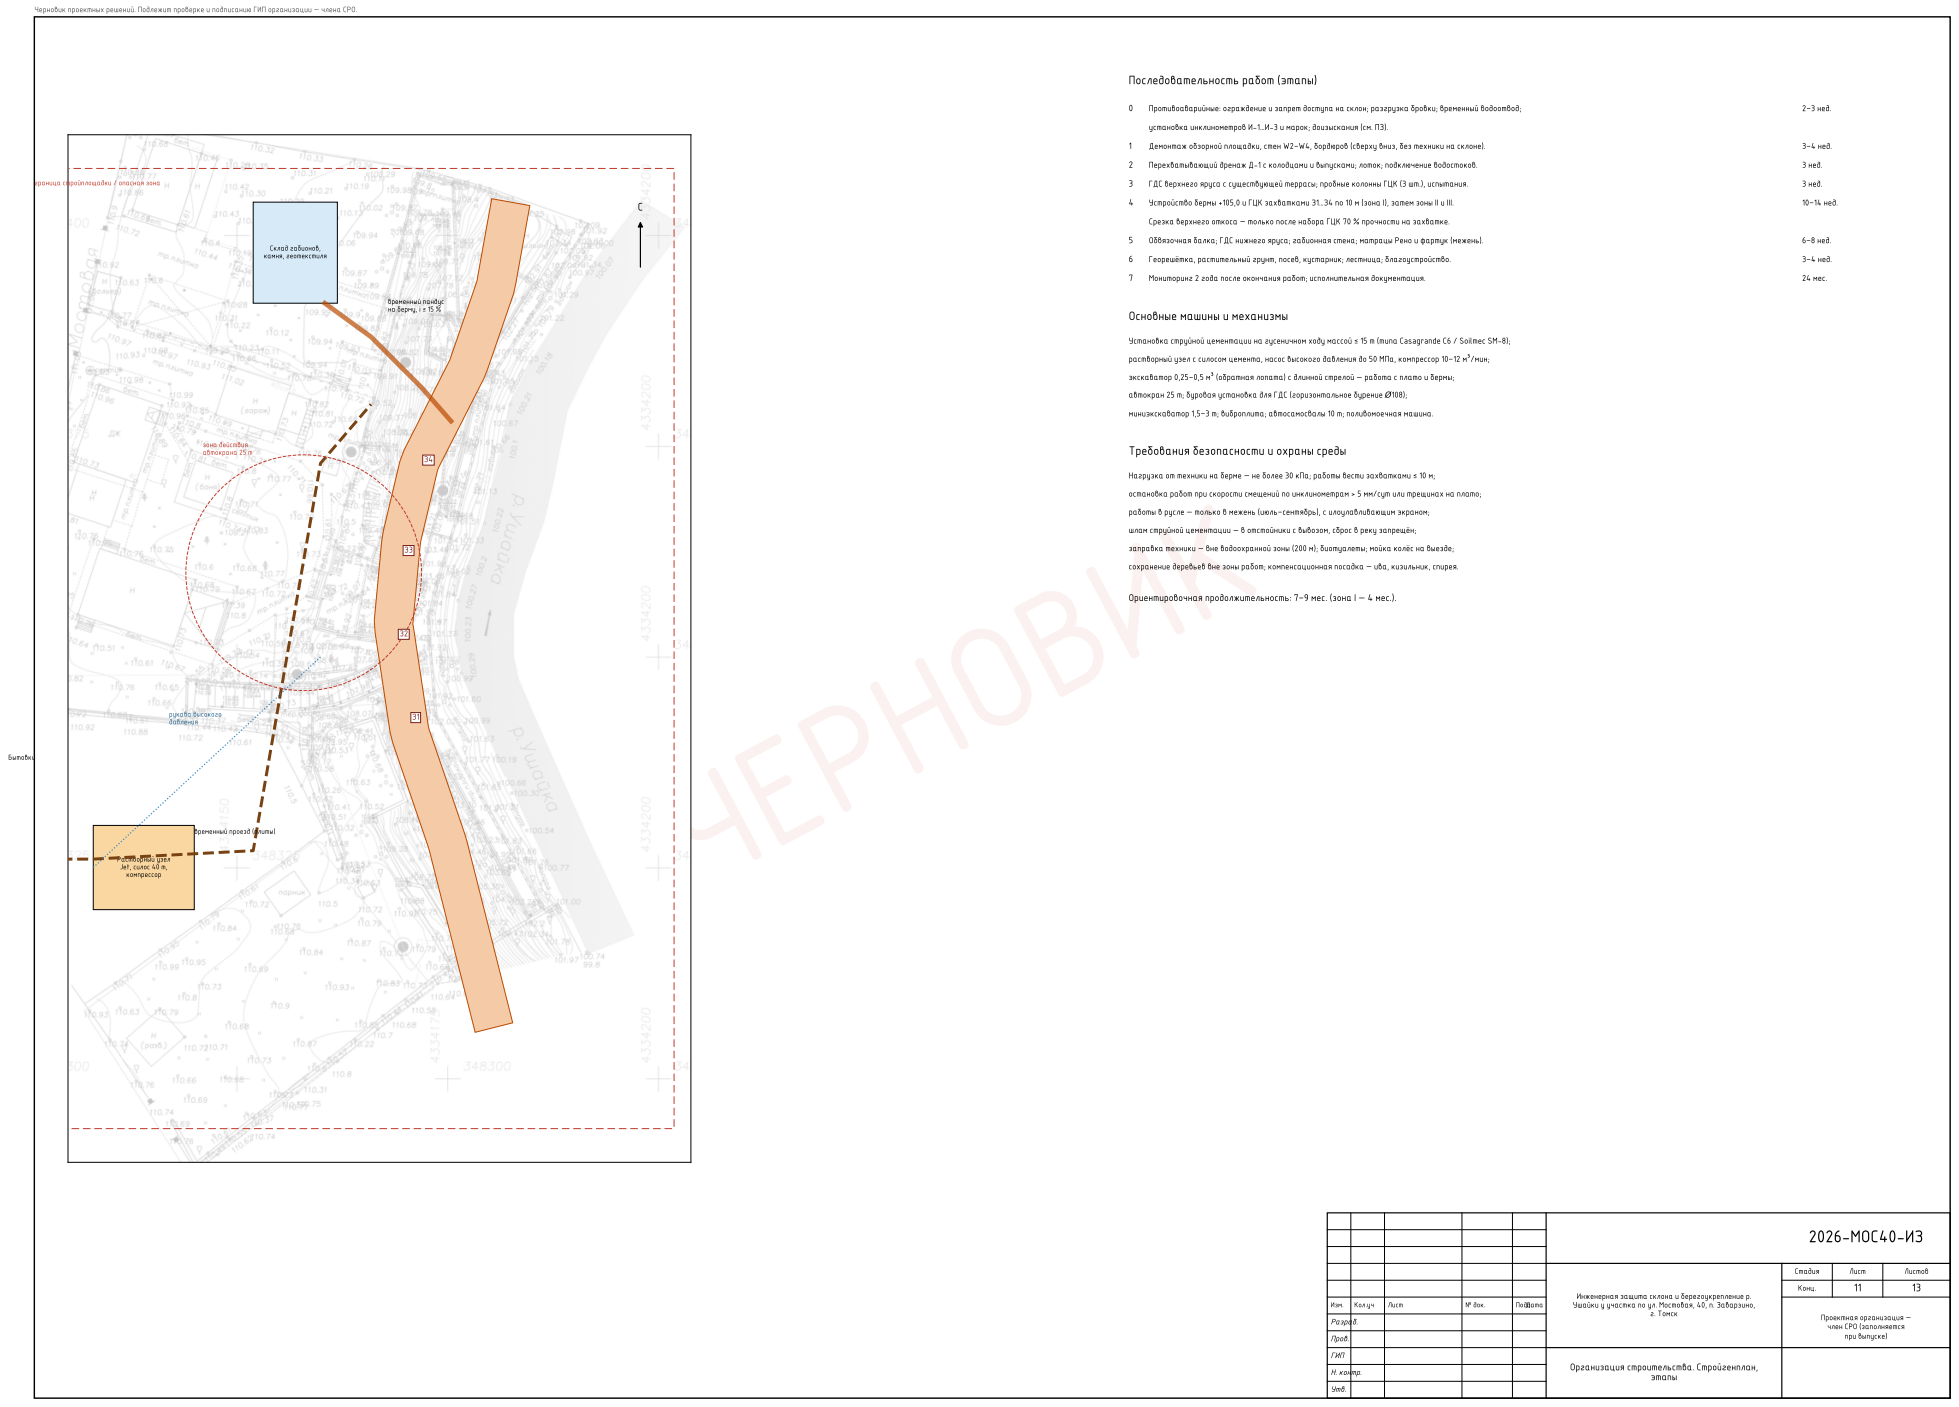
[picture p49: page 11]
II III.; Casagrande C6 / Soilmec SM-8);; Jet,

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

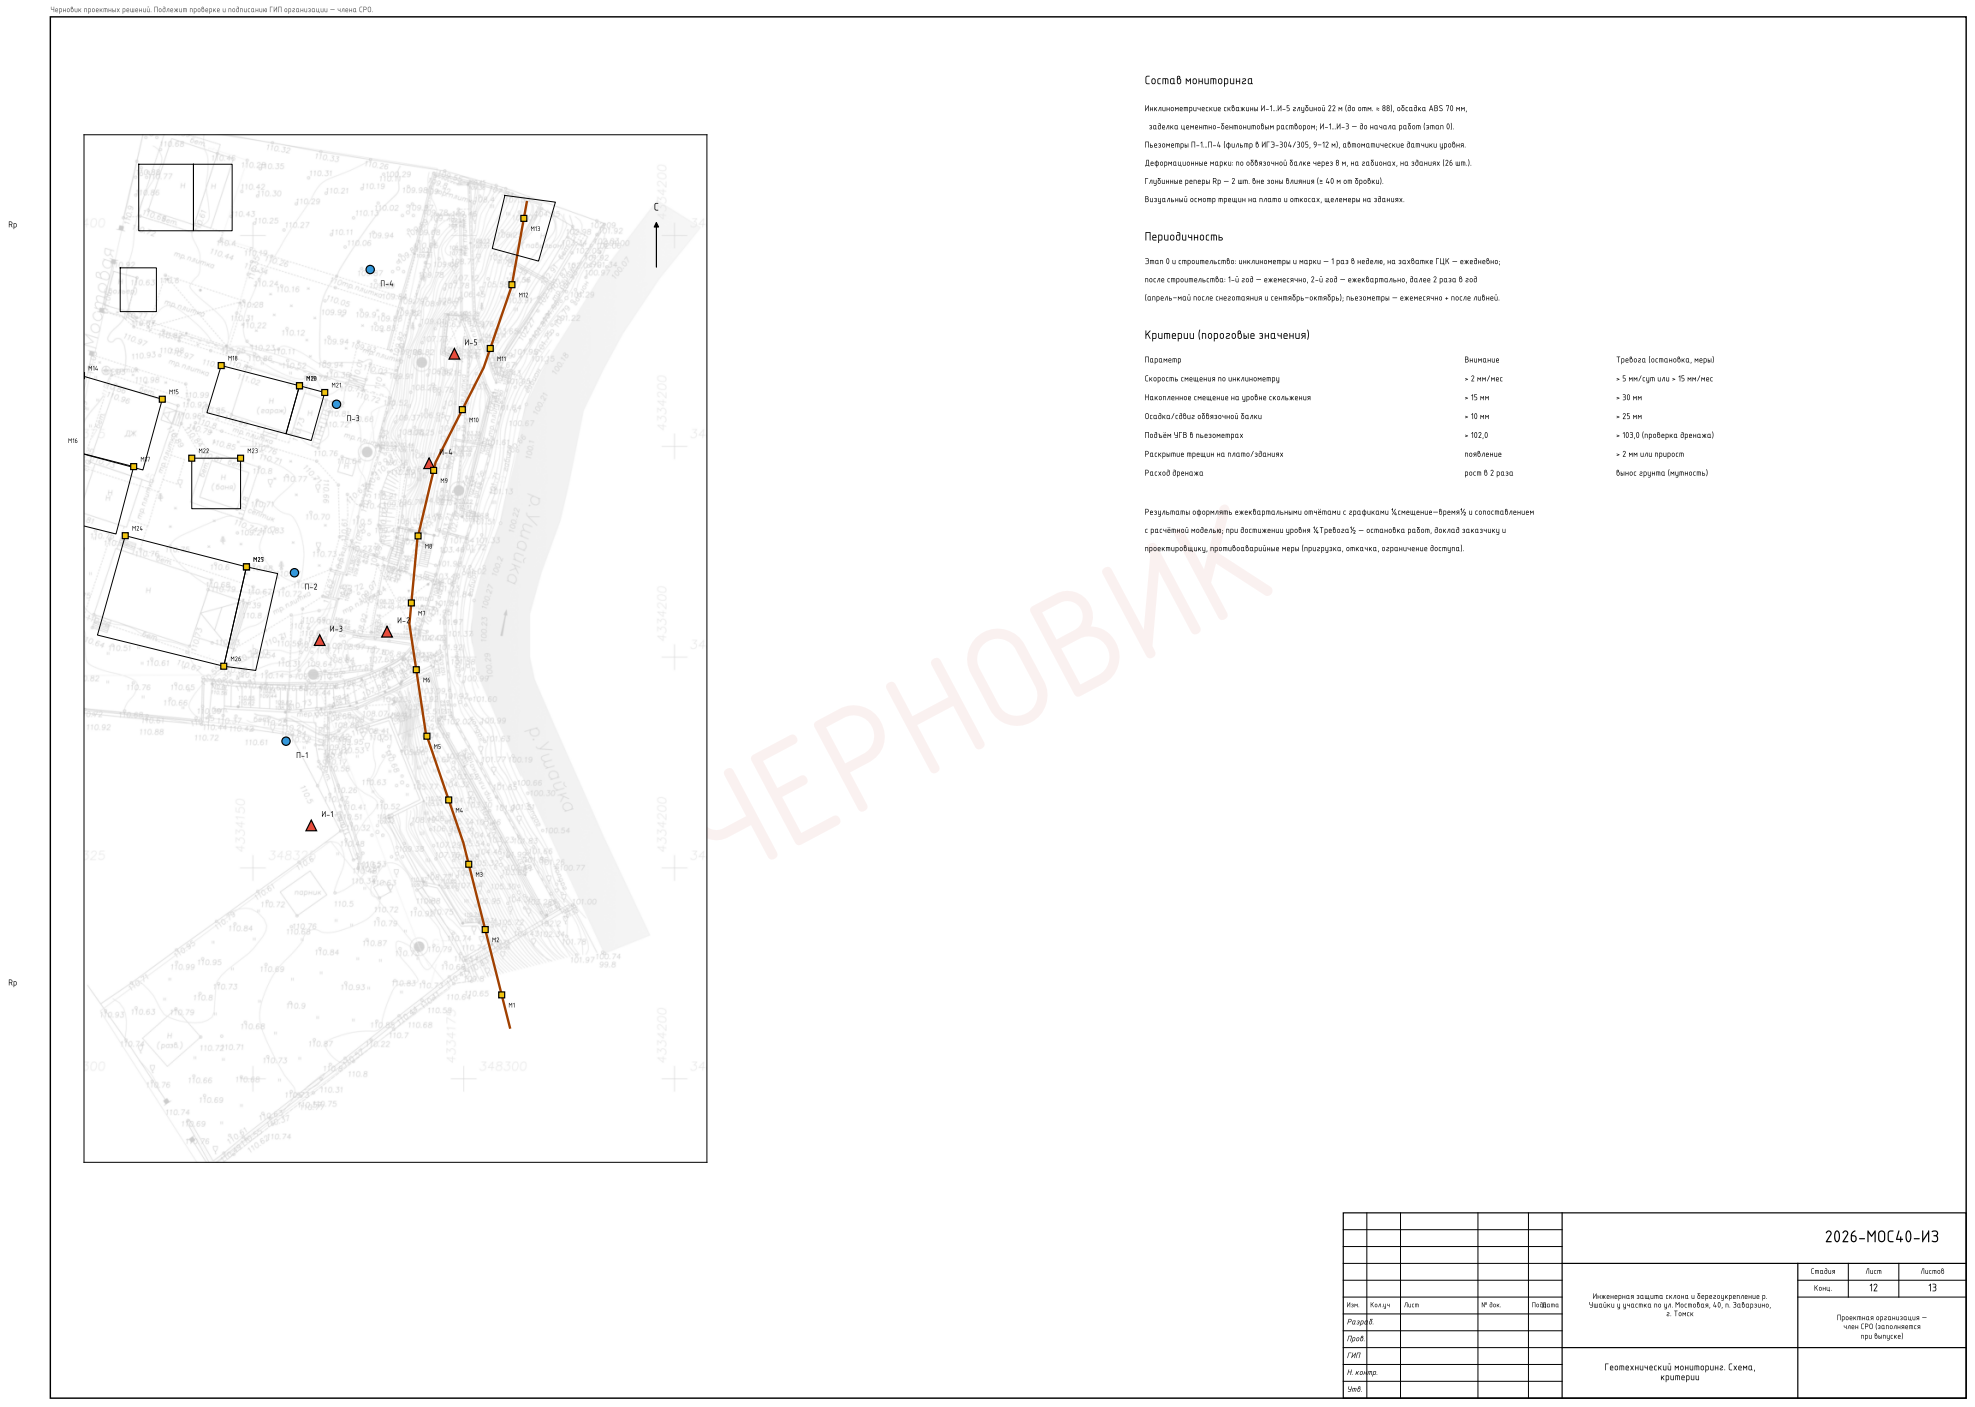
[picture p50: page 12]

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

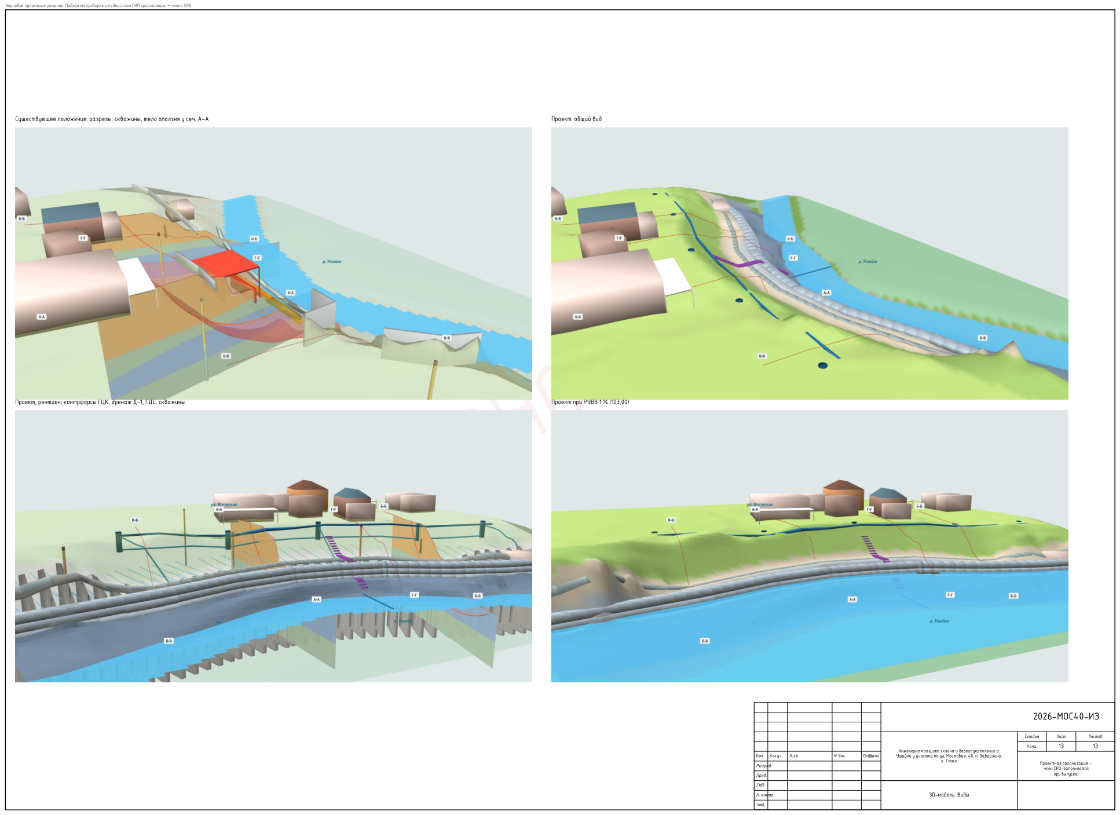
[picture p51: page 13]
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
