UrryUrr/ushayka-sklon-3d/(commit log)

2026-10-22 Сайт-презентация: берег Ушайки, ул. Мостовая, 40
    [Plan_razrezy_MSK70.dxf, Smeta_2026-MOS40.xlsx]
2026-10-22 Ссылка на сайт в записке и справке, обновлённая записка
2026-10-25 План первоочередных мер и оценка винтовых свай; исправлен значок диаметра на чертежах
    [Smeta_2026-MOS40.xlsx]
2026-10-25 Параллельный проект: первоочередные меры (pm/); основной проект — ссылка на него
    [Smeta_2026-MOS40.xlsx, Smeta_PM_2026-MOS40.xlsx]
